TheDjabra/doggobot/docs/architecture.md

# Architecture

## The one integration point

The car already runs the UCSD robocar ROS2 framework (`ucsd_robocar_hub2`). The entire seam
between this project and that framework is a single topic: **`geometry_msgs/Twist` on
`/cmd_vel`**, consumed by `vesc_twist_node` in `ucsd_robocar_actuator2_pkg`. `linear.x` is
throttle, `angular.z` is steering. Publish valid Twist there and the car moves.

Nothing in the framework is forked or modified. This project adds nodes alongside it. Reading
across prior teams in the course GitHub org, the teams that extended the framework this way
consistently did better than the teams that forked it.

DonkeyCar is not used. DonkeyCar is the behavioral-cloning path from an earlier assignment
(record frames, train a CNN, let it drive). Every prior voice-controlled and target-following
team in the org also built ROS2 packages rather than extending DonkeyCar.

## The single-publisher rule

**Exactly one node publishes `/cmd_vel`.** Two publishers on one topic is not an error in
ROS2, it is a race: the actuator receives interleaved messages from both at whatever rate
each happens to run, so a "stop" and a "follow" alternate and the car twitches. Every other
behavior publishes to its own intermediate topic and an arbiter node decides.

```
voice_bridge_node   -> /voice_cmd       (FastAPI + rclpy in one process)
perception_node     -> /target_state    (DepthAI spatial detection + ObjectTracker)
behavior_node       -> /behavior_cmd    (primitives + the sequencing executor)
safety_node         -> /safety_cmd      (LiDAR proximity, e-stop)
                            |
                        arbiter_node -> /cmd_vel     <- sole publisher
```

**The same rule now applies to the camera.** Three things want to aim the pan axis: the follow
cascade, a spoken "atlas look left", and the phone's slider. `behavior_node` is the sole
`/pan_cmd` publisher and `pan_node` is the sole writer to the serial port, so the two never
interleave half-written command lines on a 1 Mbps bus.

```
follow_node        -> /follow_pan     (tracking wants the camera here)
voice_bridge_node  -> /pan_manual     (the phone slider asks for this)
stt_node           -> /voice_cmd      ("look left")
                            |
                     behavior_node -> /pan_cmd     <- sole publisher
                            |
                        pan_node -> serial -> ESP32 -> STS3215
                            |
                     /pan_state (measured angle, load, volts, temp, ok)
```

Pan priority, highest first: follow tracking, then a manual look, then recentre when idle.
Tracking outranks a manual look because the tracker is closing a loop with better information
about where the target is; a held manual angle would simply be fought once per frame.

`/pan_state` carries `ok`, which goes false when status lines stop arriving. That is what lets
the follow cascade fall back to fixed-camera behaviour instead of steering the car on a pan
angle frozen at whatever it last happened to be.

Arbiter priority, highest first: e-stop, then safety override, then the active primitive.
Its timer runs at 10 to 20 Hz and publishes on **every** tick, not only on change, because
the base controller times out on missing `/cmd_vel` messages and zeroes the motors. That
timeout is a safety property: the point of streaming commands is the failure case, when a
publisher crashes or the network drops.

## Node responsibilities

**`voice_bridge_node`** serves the phone web app and turns input into structured commands.
One process running FastAPI and `rclpy` together: `rclpy.init()`, a node holding the
publishers, spun in a background thread, with the WebSocket handler calling into it. A
separate rosbridge server was considered and rejected, because a server process is needed
anyway to serve the page over HTTPS, proxy the LLM call so the key stays out of the browser,
and run the parser.

**`perception_node`** runs the DepthAI pipeline: ColorCamera preview into a
`YoloSpatialDetectionNetwork` with StereoDepth linked, into an `ObjectTracker`, out over
XLink. The spatial network returns per-detection XYZ in millimetres computed on the camera,
so no depth math happens on the Pi. The tracker assigns persistent IDs with
NEW/TRACKED/LOST/REMOVED states, which is what "lock onto a target" means here: no hand-rolled
association logic, and the LOST state is a free grace period before declaring the target gone.

**`behavior_node`** owns the primitives, the vocabulary, and the sequencing executor, and is the
sole publisher of `/behavior_cmd`. Primitives: forward, reverse, circle_left, circle_right, wait,
stop, and follow. Follow is a primitive rather than a parallel system, so mutual exclusion is
structural: `follow_node` publishes `/follow_cmd` and this node relays it only while follow is
the active mode.

Every moving primitive is time-bounded. "Forward until further notice" is how a car ends up in a
wall when a link drops.

The executor runs an ordered list of steps. Spoken chains ("forward then circle left then stop")
are a keyword split, which covers the common case without an LLM's latency or network dependency.
A chain where any step fails to parse is refused entirely rather than partially executed. Steps
may carry an `until` condition read from `/condition_state`; nothing publishes that yet, and the
step's duration doubles as a timeout so a condition that never arrives cannot strand the car.

**`arbiter_node`** is the sole `/cmd_vel` publisher, as above.

**Threading note:** perception and control stay in separate nodes because the default `rclpy`
executor runs one callback at a time with no preemption. A vision callback that overruns
delays the control timer by exactly its overrun.

## Message types

`std_msgs/String` carrying JSON on the intermediate topics; `geometry_msgs/Twist` only at
the arbiter output. Custom ROS2 message definitions require a CMake package, which is
friction with no payoff at this scale.

## Control

**PID only.** Steering is a PD loop on the tracklet's horizontal offset from frame center.
Throttle is a PD loop on measured distance against a setpoint. LQR and LQG are deliberately
out of scope: state-space control needs a model of a plant you understand, and this vehicle
was not built by us. The class framework is PID-shaped already
(`Kp_steering`/`Ki_steering`/`Kd_steering`), so this also means less to fight.

Kalman filtering remains available as an optional smoothing layer on the target estimate,
not as a controller, and only with evidence it is needed: the ObjectTracker already runs its
own Kalman filter on-camera.

## Voice input

Two tiers, for latency and for robustness:

- **Fast path**: fixed commands (stop, wait, follow, circle, figure-8, loop) matched by
  keyword on the phone with no model call. Near-instant.
- **Slow path**: arbitrary sequences go to an LLM that emits a schema-constrained list of
  primitives from a fixed vocabulary.

The fast path alone runs the entire graded demo, so a failure of the LLM tier or its network
dependency degrades the system rather than stopping it.

Speech is captured in the browser on the phone, not on the car. This keeps speech-to-text
compute off the Pi entirely (only short text strings cross the network) and keeps the
microphone at the speaker's mouth rather than on a vehicle that is driving away.

## Target reacquisition

The camera is on a pan servo. On target loss the system holds a short grace period, then
sweeps the camera to search for the target, re-locks, and resumes. This exists because a
prior team documented reacquisition-after-loss as an unsolved problem in their own project,
where the robot simply stopped when the target left frame.

Because the camera pans independently of the chassis, steering error is the sum of the
servo's own angle and the target's offset within the frame, not the offset alone. Likewise,
the depth reading is a range along the camera's optical axis: forward distance is
`Z*cos(pan)` and lateral offset is `Z*sin(pan)`. This is implemented as the cascade below.

## The LiDAR guard, and its override

`safety_node` watches the 290 degrees the camera cannot see and vetoes motion by
publishing a zero Twist that the arbiter ranks above everything but the e-stop. It
publishes **only while intervening**, because a continuous publisher at that priority
would veto the whole system permanently.

Two properties are worth knowing, both learned on the car on 2026-09-01.

**A threshold with no hysteresis chatters.** The guard compared range against a fixed
stop distance at 20 Hz. An object sitting near that distance makes the estimate dither
across it, so the veto toggled every tick and a 3 second command arrived as a series of
lurches: 16 stop/clear cycles in one minute. A release margin and a minimum block time
fix it. Both only delay a *release*, never an intervention, which is what made the
change safe to ship: measured, the car still stops at exactly 0.25 m.

**The override is an override, not an off switch.** On a stand the guard measures the
bench, a chair leg, a foot, and vetoes every command for obstacles that are real but
irrelevant. The phone can turn it off, under three constraints:

- it defaults to ON, and boots ON, so a restart or a crash never silently leaves the
  car unguarded;
- it is re-enabled automatically whenever the last client disconnects, alongside the
  disarm, because the operator who switched it off has walked away;
- the guard keeps **running** while overridden. It still computes and publishes what it
  would have stopped for, so the page shows "would stop: right" rather than going blank.
  Only the veto publish is withheld. The operator can therefore see what they are
  overriding, which is the difference between an informed override and a blindfold.

## The follow cascade

The camera and the steering are not two controllers on one error. They are a cascade, and each
loop closes on a different error:

| Loop | Error | Actuator | Job |
|---|---|---|---|
| inner | `x`, bbox offset | pan servo | keep the target centred in frame |
| outer | bearing | steering | point the chassis where the camera looks |
| outer | `z_mm` | throttle | hold the standoff |

The camera chases the target and the car chases the camera. When the pan angle returns to zero
the car is aimed at the target by construction. This is gaze stabilisation on a mobile base.

The bearing is the whole trick:

    bearing_deg = pan_deg + x * half_fov_deg
    err_steer   = bearing_deg / half_fov_deg

Note what that collapses to when `pan_deg` is zero: `err_steer == x`, exactly the fixed-camera
controller. So an unplugged ESP32, a dead servo, or `use_pan: false` all degrade to the old
behaviour with the old gains, rather than to a special case that only ever runs when something
is already broken.

### Why it is worth the extra actuator

Simulated before any of it touched the car, in `tools/sim_cascade.py`, which stubs rclpy and
drives the real `FollowNode` rather than a copy of its equations:

| Scenario | Fixed camera | Pan cascade |
|---|---|---|
| Approach from 28 deg off | camera 2.8 deg off target | 0.3 deg |
| Tight turn, 31 deg off at 1.7 m | 16.6 deg off | 0.6 deg |
| Person walks around a car stopped at the standoff | **target out of frame 89% of frames** | **0%** |

The last row is the case that justifies the hardware. Once the car reaches the standoff it
stops, and a non-holonomic vehicle cannot change heading while stopped. From that moment the
chassis has no authority over framing at all and the camera is the only thing that can aim.

### The traps, and what was done about each

**Stale angles.** `x` describes a frame captured about 100 ms ago; the pan angle read now is
not the angle the camera had when that frame was taken. At 120 deg/s that is 12 degrees of
fiction, larger than the errors being controlled, and it presents as a mistuned gain that no
amount of tuning fixes. `follow_node` keeps a ring buffer of `(timestamp, angle)` and looks the
angle up at the frame's own stamp, offset by `capture_lag_s`.

**Three signs meet here** (`x`, pan, `angular.z`) and any one of them backwards turns
convergence into divergence. They are defined once, in the `pan_node` docstring. The simulation
deliberately inverts each one as a control case, so the test is known to be able to see the
failure it claims to rule out.

**A car cannot strafe.** Above `align_before_drive_deg` the throttle is cut, because closing on
a target 50 degrees off the nose mostly makes the angle worse; below it the throttle is scaled
by `cos(bearing)`. If the camera stays pinned beyond `pan_escalate_deg`, the chassis has failed
to come round and steering harder cannot help, so `behavior_node` can escalate to a three-point
turn. That escalation ships **off** by default: it is the newest path here and a surprise
three-point turn during the demo is worse than a wide arc.

**Depth is a range along the optical axis**, so it stays the right error for a standoff
regardless of bearing. The throttle loop is unchanged.

## Losing the target, and going to look for it

A lock does not fail cleanly. The tracker keeps a `LOST` tracklet alive for a while to bridge a
brief occlusion, which is useful for the follow controller and misleading for anything waiting on
the lock to drop.

So the search clock starts at **`LOST`, not at lock-drop**, and after a grace period the camera
sweeps to find the target again, starting toward the side it was last seen on because that is
where it most likely still is. Priority on the pan axis is follow tracking, then a spoken look,
then the sweep, then recentre.

**The sweep is the easy half.** `perception_node` clears `want_lock` when a target is `REMOVED`,
so a camera that swept beautifully and never asked for a lock again would pass straight over the
person and latch onto nothing, while looking exactly like a camera that is working. Search
re-requests the lock, and releases it if it gives up.

The grace period earns its place too: a lock often drops for a fraction of a second when someone
turns or is briefly occluded, and sweeping instantly would drag the camera off a target that was
about to come back.

## Distances and angles, and why they are not the same problem

"Forward one metre" becomes a duration, because the class actuator node holds the motor
controller's serial port and publishes no telemetry, so wheel travel is unreadable while the
stack runs. That makes it dead reckoning, and dead reckoning is only as good as its constants.

Measured on the vehicle rather than assumed:

    distance = rate * time + coast      0.635 m/s, 0.144 m
    angle    = rate * time              45 deg/s, no coast term

**Distance needs a coast term and turning does not**, which is not obvious and is worth the
sentence. The car rolls about 14 cm after a command ends. Turning is immune because the arbiter
publishes a zero Twist when a command finishes, so the steering centres and the car coasts
straight rather than continuing round.

It matters most at the distances actually used indoors: dividing distance by a rate alone, a
0.3 m command travelled 0.45 m, fifty per cent over. `tools/calibrate_motion.py` re-measures both,
and refuses any sample where the LiDAR guard cut in mid-run, since that would quietly shorten the
result.

## Close-range framing

The camera pans but does not tilt, so a person at close range overflows the vertical field
of view and the detector sees a torso crop, exactly when the car is nearest and least able
to recover from a lost lock. Mitigations: drive the loop on horizontal offset only, never
gate on box height or aspect ratio, use asymmetric confidence thresholds (strict to acquire
a lock, lenient to hold one), and set the follow standoff above the distance where framing
degrades rather than fighting it.
