TheDjabra/doggobot/docs/MAE148-Team4-Final-Presentation.pdf

# Voice-Controlled Autonomous Navigation — DoggoBot

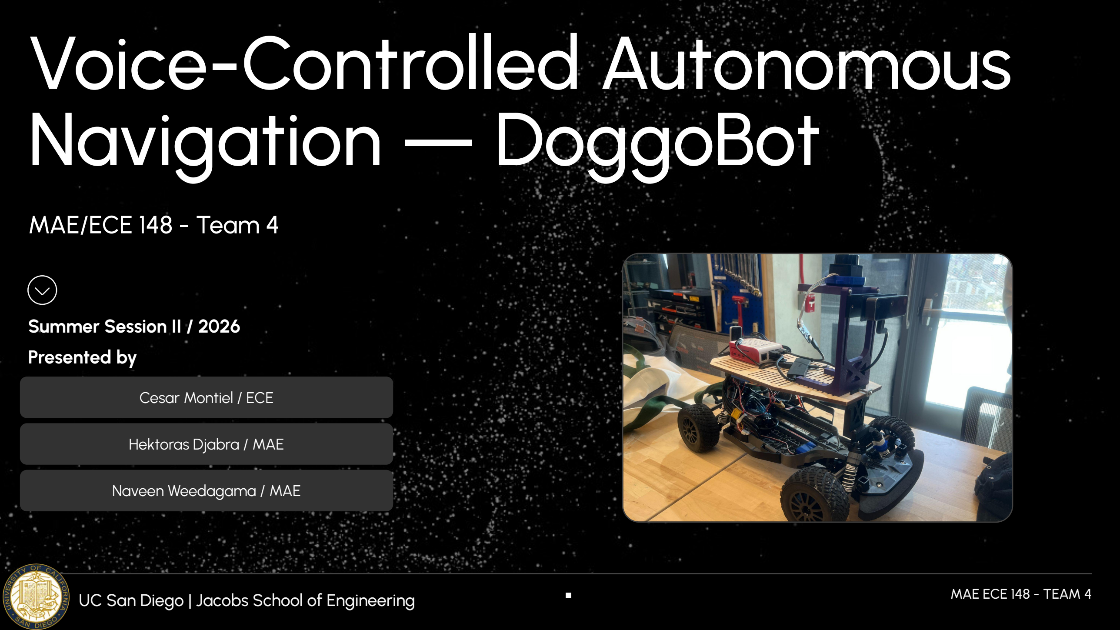
[picture p8: page 1]

Cesar Montiel / ECE

## MAE/ECE 148 - Team 4

UC San Diego | Jacobs School of Engineering

Summer Session II / 2026
Presented by

Hektoras Djabra / MAE

Naveen Weedagama / MAE

MAE ECE 148 - TEAM 4

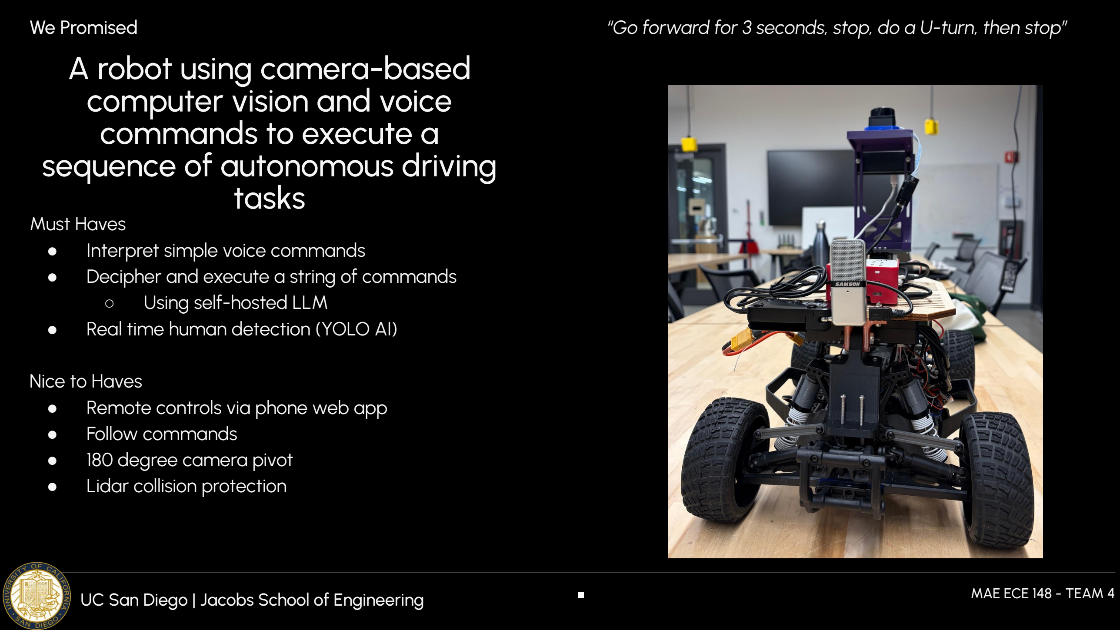
[picture p9: figure]
A robot using camera-based computer vision and voice commands to execute a sequence of autonomous driving tasks; MAE ECE 148 - TEAM 4; Must Haves ● Interpret simple voice commands; ○ Using self-hosted LLM ● Real time human detection (YOLO AI); Nice to Haves ● Remote controls via phone web app ● Follow commands ● 180 degree camera pivot ● Lidar collision protection

- Decipher and execute a string of commands
We Promised | “Go forward for 3 seconds, stop, do a U-turn, then stop”
UC San Diego | Jacobs School of Engineering

## Primary Demonstration

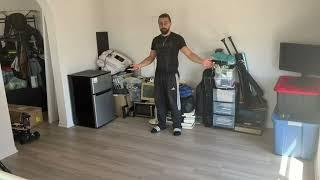
[picture p10: figure]

MAE ECE 148 - TEAM 4 UC San Diego | Jacobs School of Engineering

## Secondary Demonstration

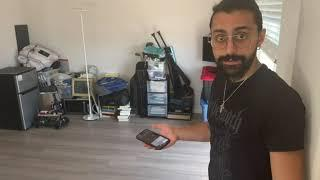
[picture p11: figure]

## What Worked

## Roadblocks

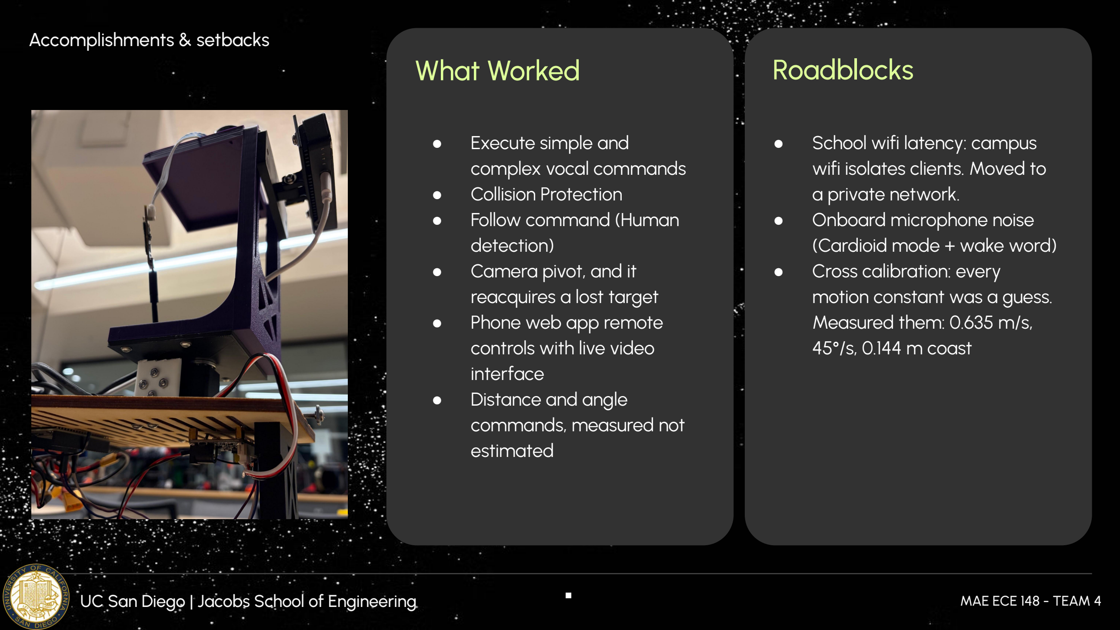
[picture p12: page 5]

- Execute simple and
complex vocal commands
- Collision Protection
- Follow command (Human
detection)
- Camera pivot, and it
reacquires a lost target
- Phone web app remote
controls with live video
interface
- Distance and angle
commands, measured not
estimated
- School wifi latency: campus wifi isolates clients. Moved to a private network.
- Onboard microphone noise (Cardioid mode + wake word)
- Cross calibration: every motion constant was a guess. Measured them: 0.635 m/s,
45°/s, 0.144 m coast

Accomplishments & setbacks

UC San Diego | Jacobs School of Engineering | MAE ECE 148 - TEAM 4

## Phone Web App

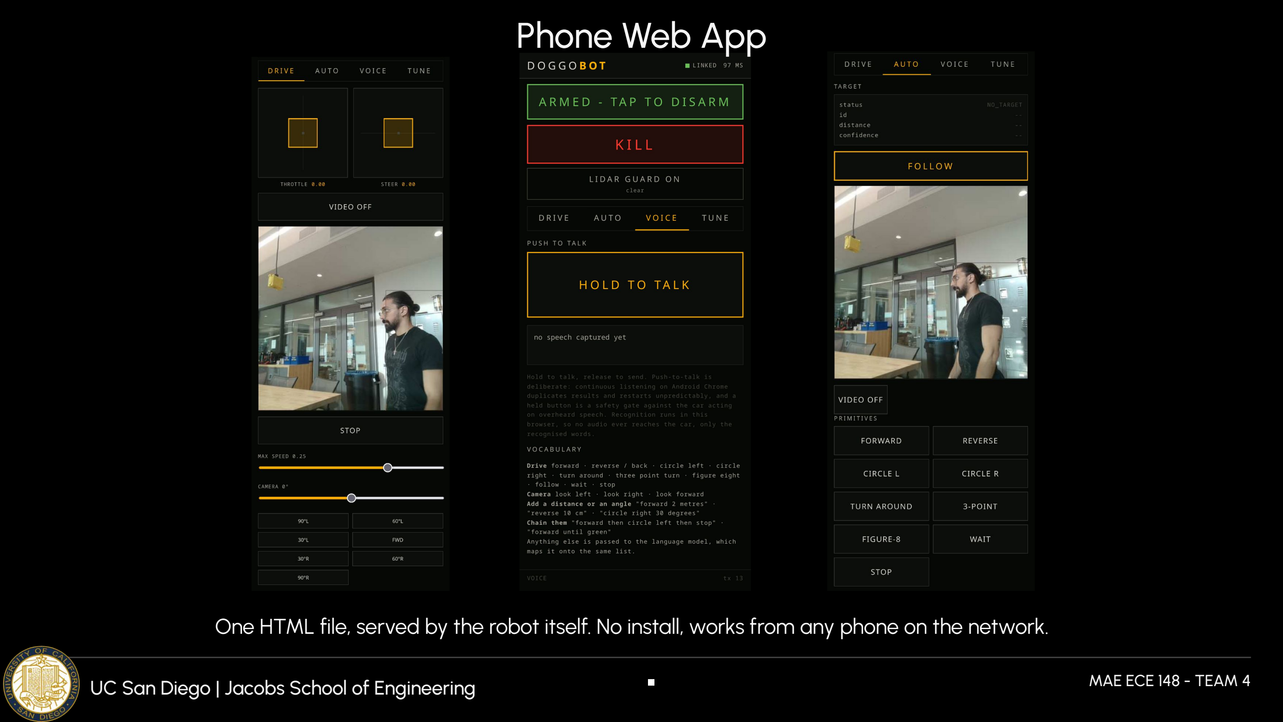
[picture p13: page 6]

One HTML file, served by the robot itself. No install, works from any phone on the network.

# What we could’ve done better

- | Better collision protection ○ | | Navigate around obstacles rather than only stopping for
| | | them
- | More robust person detection ○ | | Detector runs at 12 fps; a faster loop would track a moving
| | | person better
- Only the person class is loaded, so a coat rack can read as a
| | | person at high confidence
- Cluttered rooms degrade it
- | More robust following ○ | | The camera and steering cascade took significant tuning to
| | | stop it overshooting; more time would buy a better-behaved
| | | loop
- | Wider detection ○ | Facial recognition, so it knows its owner ○ | Objects beyond people

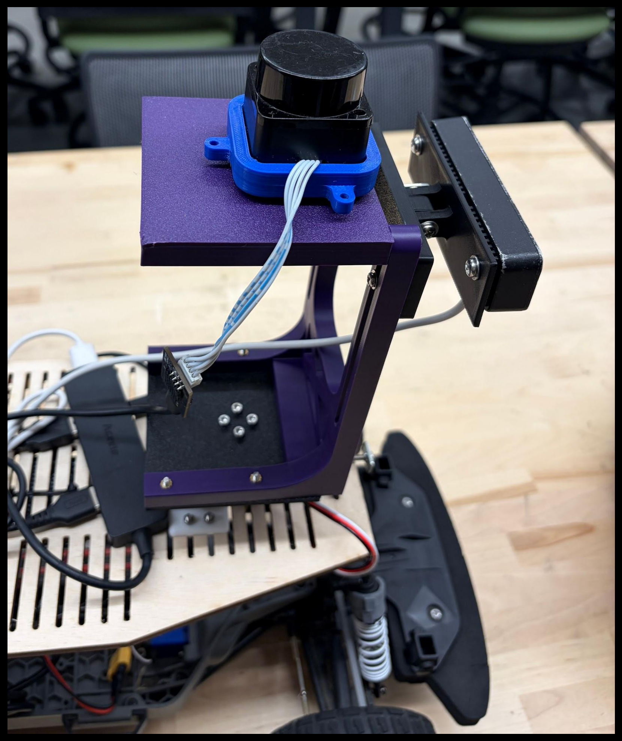
[picture p14: figure]

UC San Diego | Jacobs School of Engineering | MAE ECE 148 - TEAM 4

## Gantt Chart

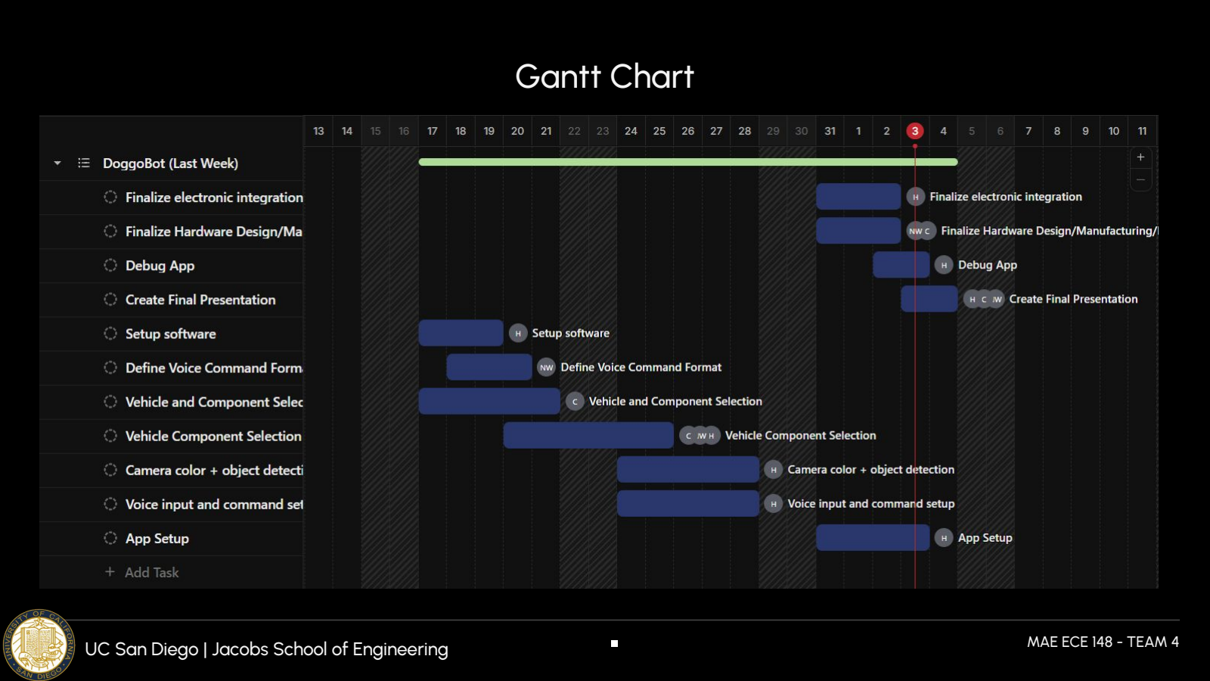
[picture p15: page 8]

# Lessons Learned

## Measure don't estimate

## Confidence is not correctness

## Ensure enough wire and mechanical clearance Capability has a compute budget

# Thank you

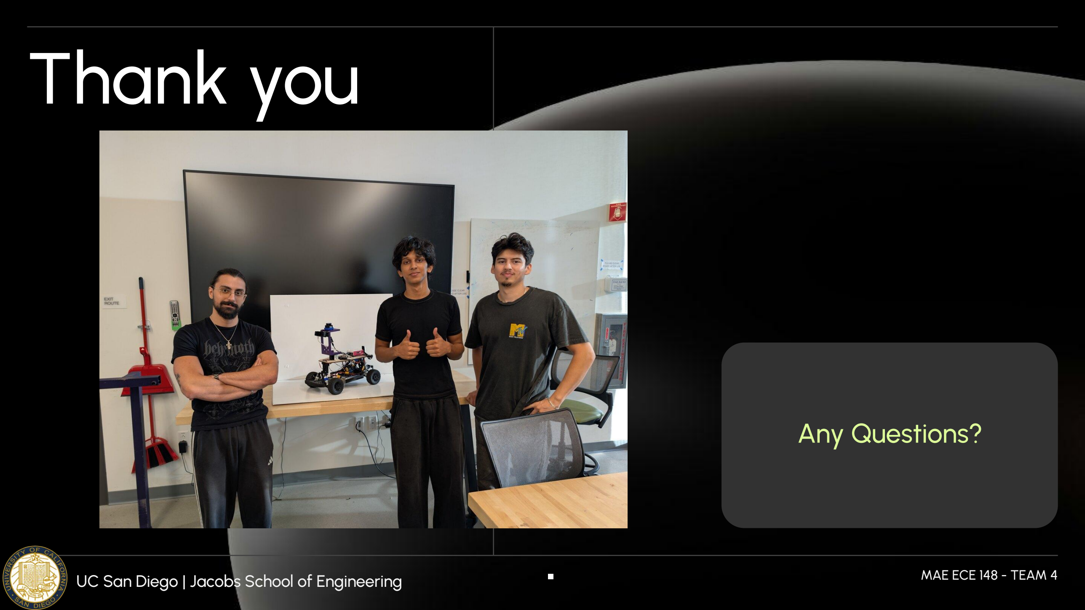
[picture p16: page 10]

## Any Questions?

UC San Diego | Jacobs School of Engineering | MAE ECE 148 - TEAM 4
