TheDjabra/doggobot/cad/Front_Support.STEP

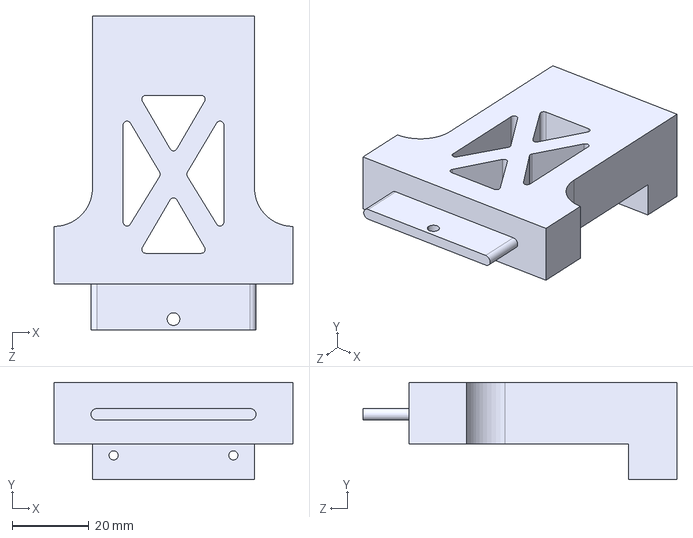
[picture p17: CAD file, 2026-09-03]
cad/Front_Support.STEP
62.2 x 25.4 x 81.8 mm
