TheDjabra/doggobot/cad/Baseplate.STEP

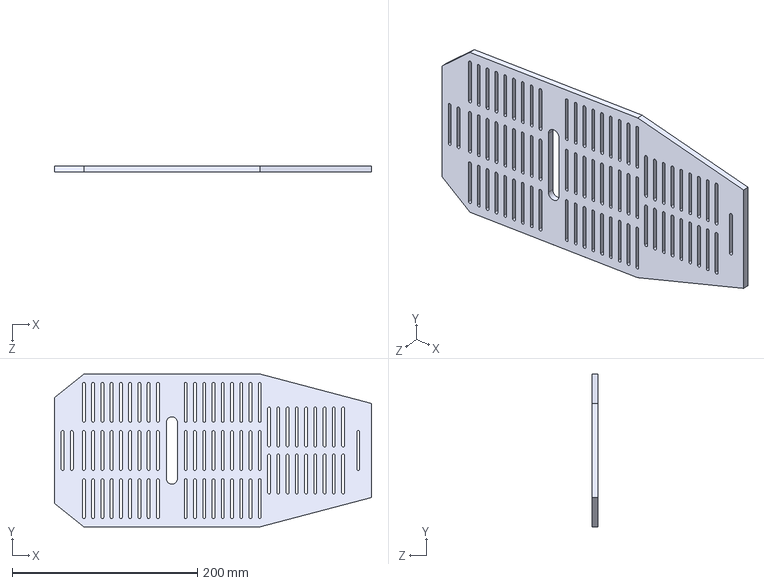
[picture p18: CAD file, 2026-09-03]
cad/Baseplate.STEP
342.5 x 165.1 x 6.35 mm
