TheDjabra/doggobot/cad/Hinge.STEP

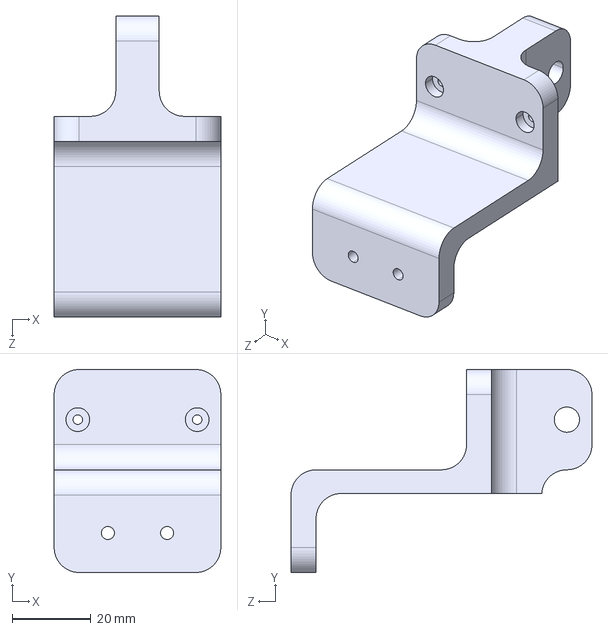
[picture p19: CAD file, 2026-09-03]
cad/Hinge.STEP
42.2 x 51.4 x 76.2 mm
