TheDjabra/doggobot/cad/Servo_To_Chassis_Mount.step

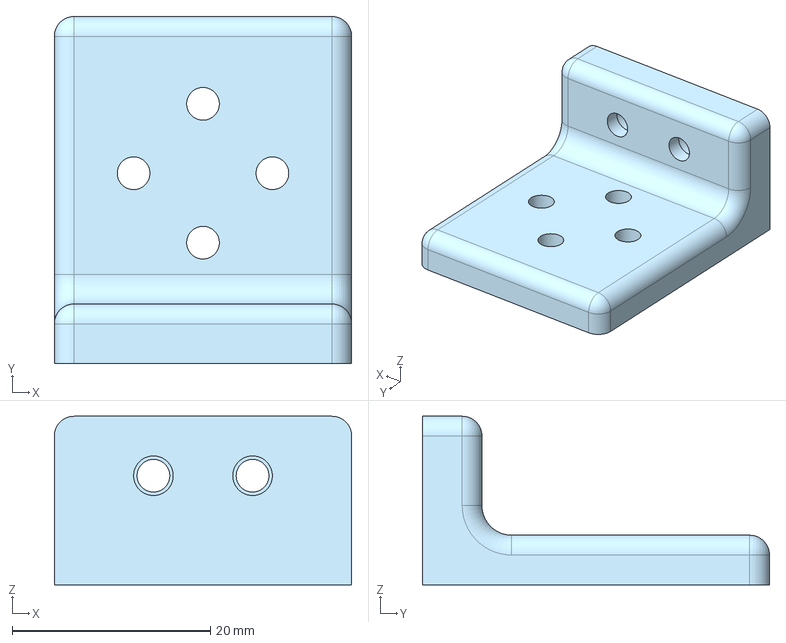
[picture p20: CAD file, 2026-09-03]
cad/Servo_To_Chassis_Mount.step
30.0 x 35.0 x 17.0 mm
