TheDjabra/doggobot/cad/Camera_Chassis_Mount.step

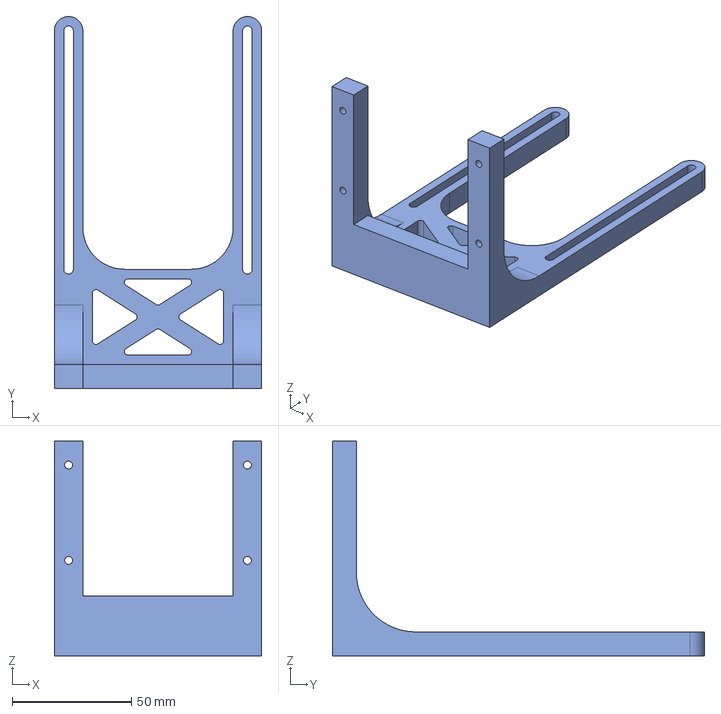
[picture p21: CAD file, 2026-09-03]
cad/Camera_Chassis_Mount.step
87.0 x 156.0 x 90.0 mm
