TheDjabra/doggobot/cad/Camera_Angle_Bracket.step

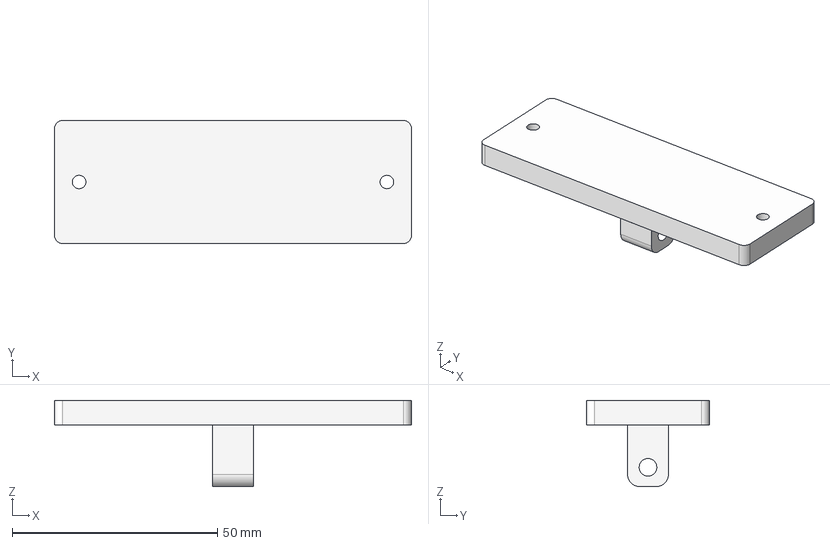
[picture p22: CAD file, 2026-09-03]
cad/Camera_Angle_Bracket.step
87.0 x 30.0 x 21.0 mm
