TheDjabra/doggobot/cad/Servo_Mount.step

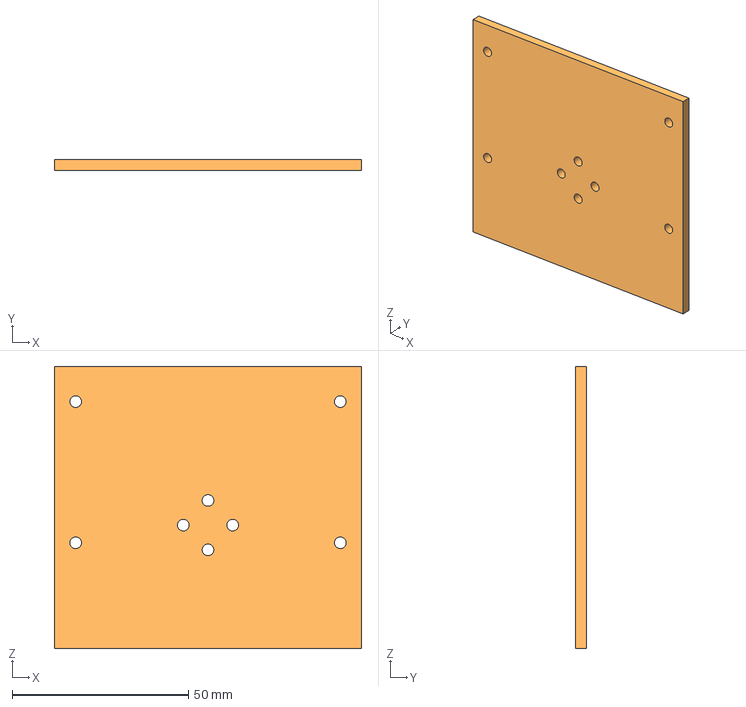
[picture p23: CAD file, 2026-09-03]
cad/Servo_Mount.step
87.0 x 3.00 x 80.0 mm
