TheDjabra/doggobot/cad/Camera_Angle_Mount.step

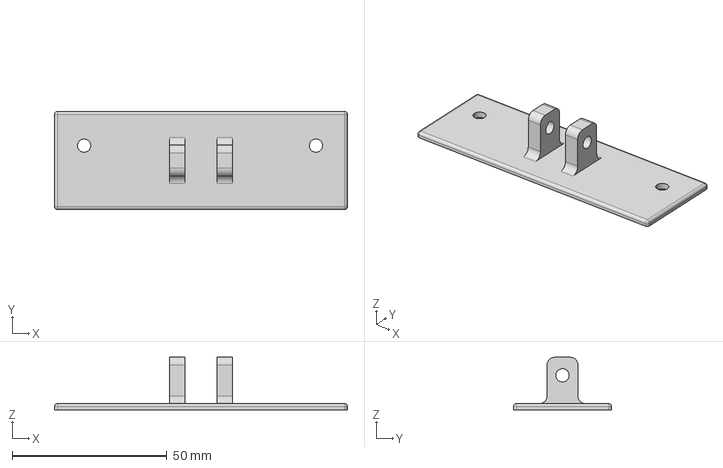
[picture p24: CAD file, 2026-09-03]
cad/Camera_Angle_Mount.step
94.8 x 31.8 x 17.0 mm
