TheDjabra/doggobot/(list of files, cad)

Other CAD files:
cad/Baseplate.STL
cad/Camera_Angle_Bracket.stl
cad/Camera_Angle_Mount.stl
cad/Camera_Chassis_Mount.stl
cad/Front_Support.STL
cad/Hinge.STL
cad/Servo_Mount.stl
cad/Servo_To_Chassis_Mount.stl
