TheDjabra/doggobot/build_log.md

# Build log

Dated engineering record: what was done, what broke, and why decisions went the way they
did. Written as the work happens, not reconstructed afterward. Source material for the
final report and the project writeup.

---

## 2026-08-25 - Container and repository set up

**Container.** The final project runs in its own container, `Doggobot`, cloned from the
graded-assignment container `robocar_team_4` rather than built fresh from the upstream
image. The reason is that three fixes made during the assignment live only in that
container's filesystem and would be lost by pulling the stock image again:

1. A settle delay added to `pyvesc/VESC/VESC.py`, fixing a partial-read race where the
   library decoded a 43-byte VESC reply after only 4 bytes had arrived and returned the
   string `None`.
2. `setuptools` pinned to 69.5.1, because the shipped 82.0.1 is above `colcon-core`'s own
   declared ceiling and breaks `--symlink-install`.
3. A corrected `source_ros2` alias that also sources `sensor2_ws`, without which the OAK-D
   packages are invisible to ROS2.

Cloned with `docker commit robocar_team_4 team4_final:base`, then run as `Doggobot`.
Verified after creation that all three fixes survived.

**Domain ID.** Set to 66 to keep this node graph separate from the assignment container's.
This had to be changed in two places, not one: the image's own `bashrc_docker.sh` exports
`ROS_DOMAIN_ID=96` on every interactive shell and overrides whatever `docker run -e` set,
so the authoritative value is the later export in `/root/.bashrc`. Verified through an
actual interactive shell rather than trusting the flag.

**Flags changed from the class `robocar_docker()` function.** Dropped `--device /dev/video0`,
which does not exist on this Pi (only `/dev/video19` through `23`, the ISP and codec nodes)
and would have made `docker run` fail. `--privileged` shares the host `/dev` regardless,
which is how the VESC and OAK-D are reachable.

**Added a source bind mount**, `/home/pi/doggobot` on the host to
`/home/projects/ros2_ws/src/doggobot` in the container. The class container mounts no
source volume, so any code written inside it exists only in a container layer, is not in
version control, and dies with the container or at kit return. A bind mount can only be
added at container creation, so it was free now and would have cost a full recreate later.

**Inherited calibration.** The clone carries the assignment's tuned values, so this
container can drive the ROS2 laps as-is: `Kp 0.2 / Ki 0.0 / Kd 0.1`, steering limits
+/-0.8, `max_throttle 0.382`, `min_throttle 0.363`.

**Note:** the two containers must not run at the same time. Separate domain IDs keep their
node graphs apart but do not stop them contending for the same VESC serial port and the
same OAK-D on the USB bus.

**Repository.** Scaffolded as an `ament_python` package so `colcon build` finds it, and
pushed to GitHub. The Pi holds a working clone at the bind-mount path.

---

## 2026-08-25 (lab) - Tailscale, arbiter_node, first bench motion

**Tailscale on the car.** Installed and joined the tailnet as `doggobot`
(`100.108.50.81`, `doggobot.tail502ca5.ts.net`). Two reasons, one immediate and one
structural. Immediate: campus wifi uses client isolation, so mDNS stopped resolving
`ucsdrobocar-148-04.local` the moment we left the home network, and the car became
unreachable. Structural: `tailscale cert` issued a real publicly-trusted certificate for that
hostname, which is what the phone app needs. The Web Speech API refuses to hand a page a
microphone on an insecure origin, so this was not convenience, it was a prerequisite for
voice input. Verified rather than assumed by issuing a cert and then deleting it.

Note: on campus wifi the tailnet connection routes through a relay in LA rather than
peer-to-peer, which adds latency. That should resolve when the phone and car are on the same
hotspot at demo time, but it needs measuring before we stream joystick input at 20-30 Hz.

**`arbiter_node`.** Written and passing a 10-case logic test with no actuator attached:
priority order, per-source staleness timeouts, latched e-stop, and output clamping. The test
harness lives at `tools/test_arbiter.sh` and is repeatable.

**`tools/env.sh`.** The first test run failed with `Package 'doggobot' not found`. Cause:
`source_ros2` is a shell *function* defined in the image's `/home/scripts/bashrc_docker.sh`,
and functions and aliases do not exist inside a child script. Sourcing that file directly is
not a fix either, because it ends with `export ROS_DOMAIN_ID=96` and would have silently moved
the project onto the wrong domain. So the environment is now explicit and version-controlled:
domain 66, every driver workspace, then ours last.

**Throttle units, corrected before commanding motion.** `vesc_twist_node` reads the
calibration file and computes `max_rpm = max_throttle * max_rpm = 0.382 * 20000 = 7640` ERPM,
then commands `rpm = 7640 * msg.linear.x`. So Twist `linear.x` is a *fraction* of an
already-capped range, not the calibration value itself. The arbiter's `max_throttle` is
therefore a second, project-level speed limit, and it was initially set to 0.382 under the
wrong assumption. Lowered to 0.15 (roughly 1150 ERPM) as a deliberately slow bench default, to
be raised only after speed is measured on the ground.

Also worth noting: `vesc_twist_node`'s callback does **not** clamp steering to
`max_left_steering`/`max_right_steering`. It computes those limits and never applies them. The
arbiter's clamp is therefore the only thing preventing an out-of-range servo command.

**First bench motion, and the bug it caught.** With the car on blocks, a steering sweep
produced servo noise but no visible wheel movement. `ros2 topic info /cmd_vel` reported
**Publisher count: 2**. An orphaned `arbiter_node` from the earlier test run was still alive
and publishing zeros at 20 Hz, so the VESC was receiving 0.8 and 0.0 alternately and the servo
was being commanded to 0.9 and back to center twenty times a second.

Root cause: `ros2 run` is a launcher and the node is its child, so `kill $!` in the test script
killed the launcher and orphaned the node. Fixed in `tools/test_arbiter.sh` by killing the node
by name and by adding a preflight check that refuses to run when an arbiter is already alive.

This is worth remembering as a class of bug rather than an incident: **the symptom looked
exactly like a hardware fault** (servo buzzing, nothing moving), and nothing in either node's
logs was wrong. `ros2 topic info` was the tool that found it in seconds. It is also a direct
vindication of the single-publisher rule the whole architecture is built on.

**Silent motor, and the measurement that explained it.** First throttle commands (0.05, 0.10)
produced no wheel movement. Rather than guess, `tools/vesc_probe.py` was written to talk to the
VESC directly with ROS out of the picture: read telemetry, then step RPM and read back what the
motor actually did. Result: firmware 6.6.55, 15.1 V input, no fault codes, and a motor start
threshold **between 500 and 1000 ERPM**. The failing commands were 382 and 764 ERPM. Not a
fault, a deadband.

That also exposed a mistake made earlier the same session. The arbiter's throttle ceiling had
been lowered to 0.15 on the reasoning that `vesc_twist_node` already caps at 0.382. It does, but
the class's own `lane_guidance_node` publishes `linear.x` between 0.363 and 0.382, so 0.15 was
*below the speed the car is calibrated to drive at*. Ceiling restored to 0.382, with the
measured floor of 0.13 recorded as a parameter and published in the arbiter's status so
behaviours can respect it.

**A second two-publisher incident, same root cause, different mechanism.** A cleanup command
`pkill -f arbiter_node` matched the very shell that was running it, so the shell killed itself
partway through and the remaining kills never executed. A subsequent launch then created a
second stack. Fixed with `tools/stop_stack.sh`, which matches installed binary paths using
bracket patterns (`arbiter_nod[e]`) that cannot match its own command line, and verifies nothing
survived. The lesson generalises: `ros2 topic info /cmd_vel` reporting a publisher count other
than 1 is now the first thing checked before any bench test, and both test harnesses refuse to
run otherwise.

**Battery.** Measured 15.1 V, so a **4S** pack, which is what every team received. The recorded
VESC motor-wizard configuration says 3S Li-ion. If that is still set, the low-voltage cutoff
will not protect this pack. Flagged for checking in VESC Tool.

**Bench results, all with the car on a stand and exactly one publisher on /cmd_vel:**

- Steering: full right, center, full left, center. Polarity correct, right command gives right.
- Throttle: 0.20 and 0.37 both spin at visibly different speeds. Reverse works at -0.25 and
  -0.37, no brake-then-reverse sequence needed.
- **Deadman**: teleop publisher killed mid-drive with no stop command sent, car stopped itself.
- **E-stop**: engaged while a 0.25 throttle command was still streaming, output zeroed; cleared,
  control resumed with nothing republished.

The drive path is therefore proven end to end: `ros2 topic pub` -> arbiter -> `/cmd_vel` ->
`vesc_twist_node` -> VESC -> wheels, with both safety paths validated on real hardware before
any autonomous behaviour exists.

---

## 2026-08-25 (lab, later) - Phone control surface

**Tailscale on the car.** Joined the tailnet as `doggobot`
(`doggobot.tail502ca5.ts.net`). Two reasons. Campus wifi uses client isolation, so mDNS stopped
resolving the car entirely the moment we left the home network. And `tailscale cert` issues a
real publicly-trusted certificate for that hostname, which is a hard prerequisite for the voice
work: the Web Speech API refuses to give a page a microphone on an insecure origin. Verified by
issuing a cert, not assumed.

**`voice_bridge_node`.** FastAPI, a WebSocket, and `rclpy` in a single process. rclpy spins in a
background thread and the socket handler publishes into it.

    button / stick  ->  /teleop_cmd   (Twist)
    kill switch     ->  /estop        (Bool)
    speech          ->  /voice_cmd    (String JSON)   [transport live, recognition not attached]

One process rather than rosbridge because a server has to exist anyway to serve the page over
HTTPS and later to proxy the LLM call so the key never reaches the browser. Given that,
rosbridge would add a second server and port for nothing.

**Design decisions in the page itself**, each for a reason worth keeping:

- **Teleop is a stream, not a command.** The page repeats the current stick position 20x a
  second. It never sends "drive until told otherwise". A phone that sleeps, locks, or leaves
  wifi simply stops transmitting and the arbiter releases the car within 0.5 s. This is the
  deadman already validated on hardware, reached from the phone side.
- **The kill switch is one WebSocket frame straight to `/estop`.** It depends on no model, no
  recognition, and no network hop beyond the bridge.
- **Sticks spring back to centre on release**, and each pad uses pointer capture so dragging a
  thumb off the pad still tracks rather than sticking at its last value. A car stick that held
  its position would be a runaway waiting to happen.
- **Speed slider starts at 0.13**, the measured motor floor, and the bridge steps smaller
  requests up to it, so a low setting still moves the car instead of feeling like a dead button.
- **Last client out stops teleop**, borrowed from the turret app's rule of disarming the payload
  when the last viewer disconnects.
- **Two-stick RC transmitter layout**: left vertical is throttle, right horizontal is steering,
  so muscle memory transfers. Each pad captures its own pointer, so both thumbs work at once.
  Landscape puts them at the screen edges with the controls between.
- **Push-to-talk, not continuous listening**, even in the skeleton. Continuous recognition on
  Android Chrome duplicates results and restarts unpredictably, and a held button doubles as a
  safety gate against the car acting on overheard speech.

Styling reuses the AI TURRET HUD's design tokens directly (square corners, bone white on
near-black, amber accent, condensed display over mono data) so the two projects read as one
system. Written as a single self-contained page rather than a React build, deliberately: a Vite
toolchain would have consumed the whole available window for no functional gain yet.

**Bug found and fixed:** `self.clients` collides with `rclpy.node.Node.clients`, a read-only
property listing a node's service clients. The node died at construction with
`property 'clients' has no setter`. Renamed to `client_count`.

**Measured**: 35 ms round trip from phone to car and back, over the Tailscale relay, on campus
wifi. That is comfortably inside what a 20 Hz stick stream needs, and much better than feared.
Worth re-measuring at Warren Mall on the phone hotspot, where it should improve further because
Tailscale can then connect peer-to-peer over the local network instead of relaying.

---

## 2026-08-26 (lab) - Perception: getting the detector running under DepthAI v3

**GPS removed**, LiDAR fitted. The USB bus is now VESC on `ttyACM0`, LD06 on `ttyUSB0`, OAK-D
on USB, which is tidier than before and frees power budget.

**The container runs depthai 3.1.0, not 2.x**, and the class's own `multi_cam_node.py` is
written against the v3 API (`pipeline.create(dai.node.Camera).build(...)`,
`requestOutput(...).createOutputQueue()`). Prior research notes said to pin v2; doing so would
have broken the course camera node. v3 has everything the follow design needs: `NNArchive`,
`DetectionNetwork`, `SpatialDetectionNetwork`, `ObjectTracker`, `StereoDepth`.

**v3 configures detection through an NN Archive, not setters.** `DetectionNetwork` has no
`setNumClasses`. Rather than re-export the model through a browser, `tools/make_nn_archive.py`
reads the blob's own tensor names and shapes via `dai.OpenVINO.Blob()` and generates a
schema-valid archive around the existing file.

**The subtype trap.** The head metadata's `subtype` must match the export format, not the
architecture generation. Measured against a single person in frame:

- `yolov6`: confidence 0.92, **garbage boxes** (normalised sizes like 8.1 x 24.0, centres
  outside the frame), ~10 per frame
- `yolov8`: one sane box, confidence only ~0.55 (reads 5 channels from a 6-channel tensor)
- `yolov6r2`: one box, confidence 0.94, stable. **Correct.**

The important lesson is that **the wrong subtype reported high confidence**. `yolov6` looked
like a working detector by every metric except the coordinates themselves, and a check of the
form "is it detecting anything" would have passed it while the follow loop chased boxes many
times the size of the image. Normalised box sizes must be within 0..1; printing them is what
found this in one run.

**Validated**: 23.0 fps at 416 (vs 25.6 natively under v2, so ~10% for the v3 pipeline and
letterboxing), 1.07 detections per frame with one person present, best confidence 0.95.

New tools: `tools/make_nn_archive.py`, `tools/probe_blob.py`, `tools/probe_detections.py`.

### Perception pipeline: measured costs, and the tracker trap

Built `tools/probe_perception.py` to measure the full pipeline (stereo depth +
spatial detection + tracking) before writing any ROS2 node that depends on it. Three
resource walls, each of which would have been a mystery later.

**1. SHAVE allocation.** The 6-shave blob refused to start: `Blob compiled for 6 shaves, but
only 5 are available`. With StereoDepth, ImageManip, SpatialLocationCalculator and ObjectTracker
each claiming cores, only 5 remain for the network. Recompiled the OpenVINO IR with
`blobconverter(shaves=5)`; no re-export from the original weights needed.

**2. Stereo median filter out of SIPP memory.** `'Median' out of system resources: '126'`.
Turned the median filter off (`initialConfig.postProcessing.median = MEDIAN_OFF`). Depth is
slightly noisier, which the host-side median we apply to Z compensates for anyway.

**3. The ObjectTracker is the bottleneck, and `setRunOnHost(True)` is the fix.**

| Configuration | fps |
|---|---|
| detector alone | 23.0 |
| + stereo depth | 7.6 |
| + tracker on-device (either type) | **1.2** |
| + tracker on host | **11.3** |
| + host tracker, FAST_DENSITY stereo | **12.1** |

Once the NN and stereo have taken their SHAVEs the on-device tracker is allocated exactly one
core and starves. Changing tracker type does not help (colour histogram 0.9, imageless 1.2); the
allocation is the problem, not the algorithm. The Pi has four idle Cortex-A76 cores, so running
it host-side costs essentially nothing and returns a 10x speedup.

**Validated at 12.1 fps**: stable tracklet id, TRACKED on 116 of 121 frames with LOST appearing
briefly as expected, depth following a person between 544 and 1034 mm.

**Model choice, settled on data.** The custom 416 single-class detector gives 12 fps end to end.
The stock COCO export is 640 with 80 classes, roughly 2.4x the pixels and a far wider head,
which would land near 5 fps in the same pipeline. If more classes are ever wanted, train a small
multi-class model at 416 rather than adopt the stock 640 one.

### Power stress test under motor load (2026-08-26)

The OAK-D and LiDAR run from a DC-DC converter off the same 4S pack that feeds the VESC, so
motor current transients sag the source that powers the camera. That failure cannot appear in a
static test, only under motion, which is how it would otherwise be discovered at a demo.
`tools/stress_power.sh` runs perception for 60 s while commanding eight full accelerate and
direction-reversal cycles.

| Measure | Result |
|---|---|
| perception fps under load | **12.3** (12.1 idle: no degradation) |
| tracker | TRACKED 731/738 frames, LOST twice |
| depth | 426 to 2054 mm |
| `vcgencmd get_throttled` | **0x0** |
| FET / SoC temp | 53.2 C |
| USB resets during the run | none |

`0x0` matters more than it looks: bit 16 of that register **latches** if undervoltage has
occurred at any point since boot, so a clean zero after eight hard cycles means the pack never
sagged enough to disturb the Pi and the converter held 5 V through every transient.

The two USB disconnects in `dmesg` are the OAK-D's normal boot and shutdown transitions, where
it re-enumerates between `Movidius MyriadX` (unbooted, `03e7:2485`) and `Luxonis Device`
(running, `03e7:f63b`). Not brownouts.

**Caveat**: the LiDAR was connected but its driver was not streaming, so this measures camera
plus motor, not full peripheral load. Repeat once the LiDAR node runs.

This demotes the powered USB hub from necessary to headroom.

### Full peripheral load: LiDAR + camera + motor (2026-08-26)

The LD06 runs from the class framework's own driver, not the full `all_nodes.launch.py` the
LiDAR assignment used (that launch also starts `lane_guidance_node`, which publishes `/cmd_vel`
and would collide with the arbiter). Just the driver:

    ros2 launch ldlidar ldlidar.launch.py serial_port:=/dev/ttyUSB0

`tools/env.sh` already sources that workspace. Publishes `/scan` at exactly 10 Hz.

Repeated the power stress test with the LiDAR streaming as well:

| Measure | Camera only | Camera + LiDAR |
|---|---|---|
| perception fps | 12.3 | **12.3** |
| `/scan` | n/a | **10.000 Hz held** |
| `get_throttled` | 0x0 | **0x0** |
| temperature | 53.2 C | 53.8 C |
| USB resets | none | **none** |

The LiDAR (direct on a Pi USB 2.0 port, ~2 KB/s) costs nothing measurable. **The powered USB hub
is optional headroom, not a requirement.** Tested in the current wiring deliberately: testing the
hub first would have proven nothing about whether it was needed, and the un-hubbed configuration
is also what exists if the hub ever fails in the field.

**Lock-on state machine validated under load.** This run's tracker statuses:
`NEW 9, TRACKED 666, LOST 187, REMOVED 2`, three distinct tracklet ids. The target was lost and
re-acquired repeatedly out to 2474 mm, so the design behaved as intended: TRACKED while visible,
LOST as a grace period, REMOVED on real departure, and a **new id on re-entry** rather than a
silently reused one, which is the `UNIQUE_ID` policy making "have I lost my target"
unambiguous. REMOVED is the signal the pan-servo sweep will trigger on.

### perception_node (2026-08-26)

Wraps the proven pipeline as a ROS2 node. Publishes `/target_state` (JSON String) at the
pipeline rate; subscribes `/target_lock` for `{"action":"lock"|"release"}`.

    {"locked": true, "id": 0, "status": "TRACKED",
     "x": -0.531, "y": -0.007, "z_mm": 449, "conf": 0.72, "age": 386, "fps": 12.3}

**`x` is an error term, not a coordinate.** Centre-relative, -1..1, so 0 means centred. The
follow controller then closes a PD loop over two numbers and no frame geometry leaks into it.

**Lock-on, not identity.** On `lock` the node picks the highest-confidence tracklet in frame and
follows that id until released or until the tracker reports REMOVED. Recognising a *specific*
person is face re-identification, far more fragile outdoors, and buys nothing for the demo.

**The camera is allowed to disappear.** The pipeline is rebuilt in a loop rather than taking the
node down, because the OAK-D re-enumerates on the USB bus whenever a pipeline starts or stops
and a brownout would look the same. `CAMERA_DOWN` is published while it is gone.

Validated on the car: lock acquired on command, same tracklet id held across hundreds of frames,
LOST appearing as a grace period without dropping the lock, release returning to `NO_TARGET`,
12.3 fps throughout.

**Observation worth acting on**: at `z_mm` ~450 confidence sat at 0.57-0.72, against 0.94 at
conversational distance. That is the close-range vertical-framing problem appearing as a
measurement for the first time: at half a metre the camera crops the body and the 0.5 threshold
has little margin. This is the number that should set the follow standoff, so measure where
confidence peaks by walking a range rather than picking 1.5 m out of caution.

### follow_node (2026-08-26)

`/target_state` -> PD on two numbers -> `/behavior_cmd`. Steering from `x` (bbox centre offset),
throttle from `z_mm` against a standoff, provisionally 1000 mm.

**Status handling.** TRACKED gets full control. LOST holds the last steering and cuts throttle:
the tracker's LOST is a grace period for brief occlusion and not a reason to drop a lock, but
driving toward something we cannot currently see is not acceptable either, so the car stops and
keeps pointing. Anything else publishes **nothing at all** and lets the arbiter's staleness
timeout release the car, which is a safer stop than a stream of zeros because it also covers
this node crashing.

**Derivative is low-passed.** The input arrives at ~12 Hz from a detector, and raw frame-to-frame
differences of a bounding-box centre are mostly noise.

**A watchdog covers perception dying**, so a frozen `/target_state` is not mistaken for "target
centred and stationary".

#### Tuning, measured rather than assumed

Steering gains started from the car's own lane-following calibration (`Kp 0.2 / Kd 0.1`). Same
servo, same geometry, same actuator scale, so a legitimate starting point. Measurement showed
the **error signal's scale differs**: with `x` normalised to +/-1 and steering clamped at +/-0.8,
`kp 0.2` gave `x=+0.455 -> steer=+0.078`, under 10% of available authority for a target half a
frame off centre. A lane centroid deviates a little; a tracked person sits at the frame edge.
Raised to **0.6**, which now gives `x=+0.509 -> steer=+0.357`.

Reverse got its own ceiling (`max_reverse 0.16` against `max_throttle 0.25`). Approaching and
retreating are not symmetric: someone stepping toward the car produces a large negative error
quickly, and the uncapped loop commanded -0.24, which reads as bolting rather than yielding.

#### Validated on the stand

| Input | Commanded |
|---|---|
| `x=-0.014` (centred) | `steer 0.000` (deadband) |
| `x=+0.509` | `steer +0.357` |
| `x=-0.648` | `steer -0.388` |
| `err +1159` | `thr +0.250` (max) |
| `err +424` | `thr +0.130` (stepped to the motor floor) |

**This validates the control LAW, not the control LOOP.** On a stand the car cannot move, so the
error never responds to the output. Overshoot, oscillation, settling time, and whether `kd`
amplifies detector noise are all invisible until the wheels are on the ground. Ground testing is
also when the 1000 mm standoff gets refined against where detector confidence actually peaks.

**Diagnostic lesson**: the first attempt polled `/target_state` and `/cmd_vel` separately about
0.8 s apart, producing pairs that looked like control bugs (a positive throttle next to a
too-close distance) and were pure sampling skew. The controller now logs its inputs and outputs
from the same message, which is the only trustworthy way to read a control loop.

### GROUND TEST: the follow loop works (2026-08-26)

First closed-loop run with the wheels on the floor, using `all.launch.py` with
`follow_firstrun.yaml` (max_throttle 0.15, reverse off, 200 mm deadband) and the phone in hand
for the kill switch. **It follows.** Steering polarity correct, no runaway, no oscillation
severe enough to note.

Also fixed just before the run, and it was a real bug rather than a quirk: on REMOVED,
`perception_node` cleared the locked id but left the lock REQUEST standing, so the next frame
grabbed the highest-confidence person in view. Stepping out of frame and returning silently
handed the lock to someone else. Now REMOVED drops the lock entirely (`relock_on_loss: false`)
and the operator is told. The parameter exists because the pan-servo sweep will want deliberate
re-locking later, which is different: a sweep re-locks having actively searched, rather than
accepting whoever wandered past.

Phone app gained a **FOLLOW/RELEASE** button and a live target panel (status, id, distance,
confidence at 5 Hz). The button reflects what the ROBOT reports rather than what was last
tapped, so a dropped lock turns it off by itself and the two can never silently disagree.

**Known limitation, confirmed in a small room: turning radius.** Worth being precise about the
cause, because it changes what fixes it.

- Raising the steering gain has little headroom left. `max_steer` is 0.7 against the arbiter's
  0.8 clamp, and 0.8 is the calibrated mechanical limit of the servo.
- The car's minimum turning radius is Ackermann geometry. No gain changes it.
- **What the pan servo actually fixes is not the radius, it is losing the target while turning.**
  The camera currently points where the chassis points, so a tight turn sweeps the target out of
  frame exactly when tracking matters most. With the camera panning independently the car can
  take a wide, achievable arc while keeping the target centred throughout.

So the pan servo is not only a reacquisition feature; it is what makes following viable in a
confined space. That reframing should carry into the mount design.

### behavior_node and on-robot speech (2026-08-26)

**Primitives**: forward, reverse, circle_left, circle_right, wait, stop, plus follow. Every
moving primitive is **time-bounded** by default (3 s, circles 6 s, cap 15 s). "Forward until
further notice" is how a car ends up in a wall when a link drops; a duration makes every command
self-limiting. Same reasoning as fall-2024 Team 12 packing a timeout into their messages.

**An architectural fix went in with it.** `follow_node` was publishing `/behavior_cmd`, and so
would a behaviour node: two publishers on one command topic, which is exactly the race the
arbiter exists to prevent, one layer up. Resolved by making **follow a primitive**:
`follow_node` moved to `/follow_cmd` and `behavior_node` is the sole owner of `/behavior_cmd`,
relaying follow when follow is the active mode. Mutual exclusion is now structural, and
commanding any other primitive releases the target lock so the car is never simultaneously
chasing someone and driving a canned trajectory.

Verified on the stand: circle left `z=-0.7`, circle right `z=+0.7`, forward `z=0.0`, matching
the physical steering polarity confirmed earlier.

**Keyword matching lives in `behavior_node`, not the phone**, because both input paths publish
to `/voice_cmd`. The vocabulary sits next to the primitives it names, so neither path can drift
from what the car can do.

#### Speech: Vosk, offline, on the Samson Go Mic

Chosen over faster-whisper (1-2 s per utterance on a Pi 5 CPU, unusable for "stop"), cloud
recognition (reintroduces the network dependency the on-robot path exists to avoid), and
Pocketsphinx (worse at everything here).

Setup notes, each of which cost time:

- **The container could not see the mic** until `docker restart Doggobot`. The `/dev` view was
  snapshotted before the mic was plugged in. Same desync already documented for other devices.
- **The Vosk model must live under the bind mount** (`models/vosk-small-en`), not
  `/home/pi/models`, or the container cannot reach it. Gitignored; `tools/get_vosk_model.sh`
  fetches it.
- **ALSA devices are exclusive**: `arecord` fails while `stt_node` holds the mic, which is a
  useful signal rather than an error.
- The node negotiates audio format and falls back to the device's native rate with software
  downmix and resample, because USB mics frequently refuse 16 kHz mono.

**Diagnosis lesson.** Several recordings decoded to nothing and I began attributing it to
placement and noise. The actual cause was an empty room: the recordings were taken while nobody
was there. A noise-floor measurement (RMS 2786 with nobody speaking, ~8% of full scale) was real
and worth having, but the conclusion drawn from comparing it to a "speaking" test was unfounded
because that test had no speech in it either. **Confirm the experiment ran before interpreting
the result.**

**Cardioid mode is required.** In omni the mic hears the whole room including the Pi's cooler
inches away. Switched to cardioid, recognition went to six of six commands correct:
`'reverse' 'stop' 'circle left' 'stop' 'go forward' 'stop'`. Also note peak hit 32767 (clipping)
when speaking close; back off or reduce gain, since clipped speech loses the detail a recogniser
needs.

**Bug found by testing: Vosk's constrained grammar is a WORD list, not a phrase list.** Given
"back up" in the vocabulary it returns bare `"back"`, which matched none of the full phrases in
the keyword table. Single-word forms added. This is the sort of thing that only appears when a
real person says a real word.

End to end confirmed: speaking "circle left" ran the circle for 6 s and "go forward" ran forward
for 3 s, with nothing typed.

### The throttle floor was wrong: 0.25, not 0.13 (2026-08-26)

Symptom, spotted by Hektoras: the drive was jumpy, and slow even on the ground.

Measured with `tools/vesc_smoothness.py`, which commands a range of ERPM and samples the ACTUAL
rpm repeatedly at each step, because a speed controller that cannot hold a setpoint shows up as
spread between samples:

| throttle | ERPM cmd | rpm mean | spread | motor A | |
|---|---|---|---|---|---|
| 0.100 | 764 | -2 | 42 | 0.17 | does not turn |
| 0.130 | 993 | 1049 | **1676** | **14.60** | jumpy |
| 0.160 | 1222 | 1342 | 708 | 12.76 | jumpy |
| 0.200 | 1528 | 1489 | **1822** | 7.05 | jumpy |
| **0.250** | 1910 | 1896 | **159** | **3.02** | **smooth** |
| 0.300 | 2292 | 2286 | 139 | 2.88 | smooth |
| 0.363 | 2773 | 2767 | 162 | 3.02 | smooth |

**The mistake, and it is worth naming precisely.** Earlier I measured where the motor *starts*
(nothing at 500 ERPM, turning at 1000) and built the whole throttle law on it. **Starting and
running smoothly are different thresholds**, and the second is roughly twice the first. The
class calibration had been saying so the whole time: `min_throttle: 0.363` is
`lane_guidance_node`'s lower **operating bound**, not a safety limit. We had been driving at
0.15, well under half the slowest speed the platform is calibrated to use.

**The current draw matters more than the jitter.** At 0.13 the motor pulled **14.6 A** against
**3.0 A** at cruise: the FOC speed loop fighting itself. Every slow test so far has drawn about
five times normal current while going nowhere useful, which is hard on the motor, the ESC and
the pack.

Raised everywhere: floor 0.13 -> **0.25**, behaviour cruise 0.16 -> 0.30, follow max 0.15 ->
0.28, teleop ceiling 0.30 -> 0.38.

**Consequence to accept or engineer around**: the car now has no slow speed. It moves at 0.25+
or it stops, so following approaches its standoff stop-go rather than rolling in gently. The
distance deadband is what makes that tolerable.

**The real fix, not done today.** The class `vesc_twist_node` drives the VESC in **RPM mode**,
where a speed PID chases a setpoint and cannot hold low speeds. **Duty-cycle or current mode has
no speed loop to hunt** and typically goes much slower smoothly; `vesc_client` already exposes
`send_duty_cycle`. That means writing our own actuator node instead of using the class one,
which is the genuine answer to "why can't this car go slowly".

### Phone speech layer working (2026-08-26)

Primitive buttons wired, browser speech recognition attached, behaviour and target telemetry
pushed back to the phone at 5 Hz.

- **Buttons and speech converge on `/voice_cmd`**, so `behavior_node` stays the single place that
  knows what the car can do and a button cannot behave differently from the same word spoken.
- **Speech sends its top three ranked guesses.** `behavior_node` falls through to the next
  alternative when the top one is not a command, which recovers near-misses in a noisy room.
- **Firefox cannot do this at all.** It implements the Web Speech API's synthesis half and has
  never shipped `SpeechRecognition`; no flag fixes it. Chromium and Safari only. Worth stating in
  the writeup as a constraint that partly justifies the on-robot microphone path existing.

**Result: phone speech outperforms the on-board mic**, and is sometimes faster. Not surprising in
hindsight: the phone's microphone sits at the speaker's mouth with real noise suppression, while
the Samson is bolted inches from the Pi's cooler in a room measured at RMS 2786 of noise floor.
Google's recognition is also better than a 68 MB offline model.

That reframes the two paths honestly. **The on-board mic's value is that it needs no phone and no
network, not that it is better.** Phone is the primary input; the mic is the one that still works
when the phone is in a pocket or there is no connectivity.

### Boot to driving with no terminal (2026-08-26)

`deploy/doggobot.service` starts the container and the full stack at power-on
(`tools/install_service.sh` installs it). `tailscale serve` already persists across reboots, so
the URL is live as soon as the nodes are. Logs move to journald: `journalctl -u doggobot -f`.

**The stack starting is NOT the car being live.** Hektoras asked for an explicit gate, which is the
right call and better than what I first built:

**Arm gate.** The arbiter has a master enable, `/arm`, defaulting **off** at power-on. While
disarmed it publishes zeros regardless of what any source asks for. Verified: disarmed + forward
gives 0.0, armed + forward gives 0.365, and disarming mid-motion returns to 0.0 immediately.

Reasoning for a deliberate tap rather than arming on page load: a page can open by accident, be
restored by the browser, or sit in a background tab, and none of those should be able to move a
car. The bridge also **disarms when the last client disconnects**, so walking away leaves the car
inert rather than idle, and the page **disarms its UI when the link drops**, since it reflects
the arbiter's reported state rather than the last tap.

### The always-listening mic was driving the car

Found while testing the arm gate: a `forward` command produced **-0.365**. Not a sign error. The
log showed `"back" -> reverse` and `"back go" -> reverse`: **the on-robot microphone had
overheard talking and executed it.**

This is a design problem rather than a glitch. The command vocabulary is ordinary English (stop,
back, forward, wait, hold, stay, left, right, follow) and the mic listens continuously, so anyone
having a conversation near the car can drive it. The phone path never had this problem because
push-to-talk is itself the gate.

Fix: **a wake word, required per-source.** Mic commands must address the car by name
("doggo forward"); phone speech does not need it, because holding the button is already
deliberate and adding friction to the already-gated path buys nothing. Picovoice's free wake-word
tier was discontinued, so this is implemented as a prefix inside the existing constrained
grammar, which costs nothing and cannot be triggered by a word outside the vocabulary. The wake
word is accepted anywhere in the utterance, not only at the start, because recognisers routinely
prepend filler.

Verified per-source: mic "forward" ignored, mic "doggo forward" runs, phone "circle left" runs.

### Wake word: doggo -> rex -> atlas (2026-08-26)

Settled on **"atlas"**. Two syllables deliberately: a longer word gives the recogniser more
acoustic content than a one-syllable name, and "rex" additionally rhymes with a family of common
words (wrecks, checks, next, text). Both "doggo" and "rex" were tested working first, so this is
robustness rather than a fix.

Known residual risk, worth recording rather than forgetting: **"atlas" is also a Boston Dynamics
robot**, so it does come up in robotics conversation. Far lower risk than "rover" would have been
in the same room, but if phantom commands ever appear in the log, suspect that first.

**A check that did not work, recorded so it is not repeated.** I tried to verify candidate wake
words against the model's lexicon by building a grammar per word and watching for an
out-of-vocabulary warning. Vosk accepted every candidate without complaint, including invented
words, so the test proved nothing. The model ships its vocabulary compiled into `Gr.fst` with no
plain word list to grep. **The only reliable check is saying the word and seeing what comes
back.**

### Power cycle verified (2026-08-26)

Full cold boot tested: battery and power removed, restored, then straight to the phone. The
container, all seven nodes, and `tailscale serve` all came back on their own. **Powered on,
opened the app, tapped ARM, gave a command. No terminal involved at any point.**

This was the last unverified assumption in the startup path. `systemctl restart` had been working
all along, but that only proves the unit runs, not that Docker's restart policy, service
ordering, network-online, and tailscaled all sequence correctly from cold. They do.

---

## 2026-08-27 - Sequencing, video, and three real fixes

**Sequencing executor.** `behavior_node` runs an ordered list of steps, one at a time. Verified on
the car: forward at 0.0 s, circle_left at 2.1 s, reverse at 5.1 s, stop at 7.2 s.

Spoken chains work without an LLM: **"forward then circle left then stop"** splits on
`then` / `and then` / `after that`. A keyword split, not language understanding, but it covers
the common case with no latency and no network. Each step keeps its default duration.

**A chain that half-parses is refused entirely.** First implementation rejected the chain and
then fell through to single-command matching, so "forward then jump then stop" drove the car
forward. Executing a fragment of something asked for as a whole is worse than doing nothing, and
that is exactly how a robot ends up somewhere surprising. Now the whole utterance is refused and
logged.

**Condition hook is in but unwired.** A step may carry `{"until": {...}}`, read from
`/condition_state`. Nothing publishes that yet, so such a step falls back to its duration and
says so. The duration therefore doubles as a timeout on every condition, which matters: a
sequence waiting forever on a green marker it will never see is a car stuck mid-demo with no way
out.

**Video to the phone.** `perception_node` JPEG-encodes the tracker's own passthrough frame (so
the overlay always matches the image it is drawn on) and publishes `camera/compressed`; the
bridge serves it at `/stream.mjpg` as multipart MJPEG, which any browser renders in a plain
`<img>` with no client library, no WebRTC negotiation and no codec check. The app has a Video
On/Off toggle, off by default.

Encoding runs only when something is subscribed and at 8 fps against the pipeline's 12: not
watching costs the car nothing, and video should never take cores from the control loop.

### Three fixes, each found by something behaving oddly

**Follow no longer reverses**, and the deadband widened from 150 to 300 mm. With the throttle
floor at 0.365 there is no slow speed, so the loop is bang-bang: it overshot the standoff,
reversed, overshot the other way, and yo-yo'd around 1 m. Driving up and stopping is also better
behaviour on its own terms, since a car backing away from someone walking toward it reads as
skittish.

**Disarm now has a 10 s grace period.** The disarm-on-last-client-disconnect rule fired three
seconds into a running sequence when the phone's WebSocket dropped. Phone browsers close sockets
constantly (screen sleep, backgrounding, network blips). Walking away should still make the car
inert, so this is a delay with a cancel-on-reconnect, not a removal.

**ROS2 discovery is asynchronous, and publishing into it is silent success.** A test script
created a publisher and published about a second later; sometimes the far side had connected and
sometimes it had not, with no error either way. That intermittency is worse than a consistent
failure because it looks like a logic bug. Any script that starts, publishes and exits must wait
for `get_subscription_count() > 0` rather than sleeping and hoping.

### A process note on my own error

The duplicated video code that crashed `perception_node` at startup
(`ParameterAlreadyDeclaredException: ['video_fps']`) came from an edit that had partially applied
before an interruption. I assumed an interrupted tool call meant nothing was written. **Check
file state after an interruption instead of assuming it was atomic.**

---

## 2026-08-29 - Colour detection, conditional commands, LiDAR guard

### Colour detection

HSV thresholding in `doggobot/color.py`, run inside `perception_node` because only one process
can own the camera. Publishes `/condition_state` at 5 Hz, which the sequencer's `until` hook was
already waiting for, so this was a publisher rather than a rewrite.

**Red needs two hue bands.** OpenCV maps hue to 0-179 and red sits at *both* ends, roughly 0-10
and 170-179, so a single range cannot express it. This is the classic HSV mistake and it presents
as "red sort of works", which is worse than failing outright.

**Largest contour, not total pixel count.** A wall speckled with matching pixels should not
outvote an actual object.

**Thresholds are data, not code**: loaded from and saved to JSON, updated live over a topic. A
phone tab has per-channel sliders and tints matching pixels on the video feed, so tuning is done
by eye at the venue rather than by editing a file and restarting.

**Tuning is deferred to the venue.** The demo is indoors at 11:30 on Friday with room lighting
plus daylight through large windows, which means **mixed colour temperature**: the same target
reads a different hue depending on which source dominates where it stands. Thresholds tuned in a
bedroom will not transfer. Also worth doing then: lock the camera's white balance and exposure,
because auto-WB actively changes colour rendition as the car moves, which invalidates any fixed
threshold.

`color_react` test mode drives forward on green and reverses on red, continuously, from a button.
It exists so thresholds can be checked against real motion with the wheels up and without
speaking. Bounded at five minutes: an open-ended reactive mode is exactly what drives off a bench
while you are looking at your phone.

### Conditional commands

"forward until green" and "forward until you see green then circle left then stop" now parse
into conditional steps, with no LLM involved.

**An unrecognised condition is refused, not dropped.** The first version fell back to plain
keyword matching, so "forward until purple" drove the car forward for three seconds. Dropping a
condition you did not understand turns "drive until you see green" into "drive for three
seconds", which is a different and much worse instruction than the one given. Same principle as
the chain refusal added on 2026-08-27.

### LiDAR proximity guard

`safety_node`: `/scan` to `/safety_cmd`, finally giving the arbiter's safety input a publisher.
Covers the ~290 degrees the camera cannot see, which is the reason the LiDAR is on the car at all.

| Sector | Stop | Why |
|---|---|---|
| front | 0.45 m | **inside** the 1.0 m follow standoff |
| rear | 0.35 m | nothing else watches behind, and reversing is in the demo |
| side | 0.25 m | camera never sees them; tight because the car steers as it drives |

**Front must stay inside the follow standoff.** The person being followed is an obstacle as far
as the LiDAR is concerned, so a front threshold at or above the standoff would deadlock the
follow controller against the guard permanently.

**Publishes only while intervening.** The arbiter ranks safety above everything but the e-stop,
so a continuously publishing guard would veto the entire system forever. Silence plus the
arbiter's staleness timeout is what makes the veto momentary.

**Nth-smallest range, not the minimum**, so a lone spurious return cannot trip it. Spring-2023
Team 10 documented open areas producing phantom close points on this sensor class, which froze
their robot.

**Orientation was measured, not assumed.** `tools/lidar_sectors.py` prints a live compass so a
moving object can be told apart from furniture; a single snapshot cannot. Result:
`forward_offset_deg: 0.0`, the LiDAR's zero already points forward.

#### The circularity bug, worth remembering

The first version read `/cmd_vel` to decide which direction the car was travelling. But
`/cmd_vel` is the arbiter's **output**, which this node vetoes. Stop the car, the output goes to
zero, the guard concludes nothing is moving, releases the veto, the car lurches, repeat.

It now reads `/behavior_cmd` and `/teleop_cmd`: the arbiter's **inputs**, which are unaffected by
its own veto. **A safety system must observe intent, not an outcome it is already influencing.**

Verified on hardware: intent 0.365 forward, obstacle at 0.22 m, `control -> safety`, then
`clear` and `control -> behavior` once the path opened.

### The LLM slow path (2026-08-29)

`llm_node`: `/voice_unparsed` in, a structured command out on `/voice_cmd`. When the keyword
parser fails to match an utterance, `behavior_node` publishes the text rather than just logging
it, and this node may turn it into a sequence.

**A separate node, not inside `behavior_node`.** That node runs the control loop, and a blocking
network call inside it would stall the primitives. This way the fast path never waits on the slow
path.

**Self-hosted by choice.** Ollama on Rasputin (RTX 3070, 8 GB) reached over Tailscale, rather
than a vendor API. Two reasons. Everything else in the project already runs on hardware we
control, so the parser matching that is consistent rather than special. And as a demonstration,
"the language model runs on a machine I own" is a materially different claim from "I called an
API" is Hektoras's framing, and it is the right one.

**The schema is the safety mechanism, not the prompt.** Ollama constrains decoding to a JSON
schema whose `action` and `until_color` fields are enums of the primitives that actually exist,
so the model **cannot emit an action the car does not have**. Same trick as the Vosk grammar on
the microphone: rather than trusting a model to behave, make misbehaviour unrepresentable.

**It refuses rather than approximates.** The prompt requires `understood: false` for anything it
cannot express, and the test set includes "make me a sandwich" to check. Third time this
principle has come up: a wrong guess makes the car do something nobody asked for.

**It can only ever add.** Unreachable, slow, or nonsense responses all end in the utterance being
dropped, and the car behaves exactly as it does with no LLM at all. Verified: with Ollama not yet
installed, the node logs `llm unreachable` and everything else runs normally. The keyword path
covers every graded requirement on its own, so this tier must never become load-bearing.

Also: one request at a time. Queueing utterances would let the car act on something said several
seconds ago, which is worse than ignoring it.

#### Model choice, and why capability barely matters here

Considered Kimi K3 (2.8T parameters, MoE with 104B active, open weights, July 2026). It cannot
run on 8 GB by any route: even at 4-bit the weights exceed a terabyte, and MoE does not help
because all experts must be resident. It is an API model, which is the thing we were avoiding.

More usefully: **the parser's task is mapping words onto an enum that already exists**, and the
schema has already constrained the output space to seven actions and two colours. A frontier
model cannot do that better than a 7B, because there is no room to be better. Same reasoning that
made a 68 MB Vosk model adequate for the microphone.

Picked `qwen2.5:7b-instruct` (~4.5 GB at Q4): strong at instruction-following and JSON, leaves
headroom on the card, fast. `llama3.1:8b-instruct` is an equally reasonable swap, one string in
`config/llm.yaml`.

**Setup gotcha for whoever runs the host:** Ollama binds `127.0.0.1` by default. Set
`OLLAMA_HOST=0.0.0.0:11434` and restart it, or nothing off that machine can reach it. This is the
single most common reason a local model "works on my machine".

#### The LLM tier working (2026-08-29)

| Utterance | Parsed to | Time |
|---|---|---|
| "drive forward for five seconds then spin left twice" | forward -> circle_left -> circle_left | 0.8 s |
| "go until you see the green thing and then stop" | forward -> stop | 0.6 s |
| "back up a little bit and then do a figure eight" | reverse -> figure_eight | 0.4 s |
| "make me a sandwich" | **not understood** | 0.3 s |

All correct, including counting "twice" into two steps, mapping "spin left" onto a primitive that
is not named that, and refusing the nonsense rather than approximating.

**Two fixes were needed, and both are worth remembering.**

**The model was never slow, it was unloaded.** Cold: 50.9 s to load 4.7 GB into VRAM. Warm:
0.34 s. Ollama evicts after five minutes idle by default, which would have meant a 50-second wait
for the first command of every demo, and again after any pause. Fixed by keeping it resident
(`keep_alive`) and warming at node startup. This is the same shape as the "starting is not
running" throttle lesson: the first measurement described a state, not the steady state.

**`keep_alive` means different things depending on its JSON type.** A *string* is parsed as a Go
duration, so `"-1"` fails with `missing unit in duration`; the *number* `-1` means never evict.
The node now converts numeric-looking config values to a JSON number, so either spelling works in
YAML.

**Result worth stating plainly**: sub-second parsing on our own hardware. The whole voice stack
now runs on machines we own: speech offline on the Pi or in the phone's browser, detection on the
camera's VPU, language parsing on the desktop. Nothing about a spoken command leaves the network.

### Explicit LLM routing, and a prompt that describes mechanism (2026-08-29)

**"atlas listen ..." routes to the LLM and locks the keyword matcher out.** Hektoras's idea, and it
fixed a live bug rather than just adding convenience. Previously, saying a long sentence to the
mic let the grammar pass hear "atlas go right" inside it, match `circle_right`, and drive a six
second circle while discarding the rest. The grammar cannot represent a sentence it has no words
for, so it grabs the fragment it can. Explicit routing means the fast path never gets to interpret
part of something aimed at the slow path.

The implicit fallback remains: grammar hears nothing, free-form heard words with the wake word in
them, escalate. Forgetting "listen" degrades rather than fails.

**The free-form pass needed the same gate the grammar has.** Unconstrained recognition on an
always-on mic invents words from room noise ("surrender willing case", "i've never seen a
benign"), and each one was a needless LLM call. It now requires the wake word too. The grammar
never had this problem precisely because it cannot produce out-of-vocabulary words.

**A refused chain now escalates instead of being dropped.** Refusing a partially-parsed chain was
right when there was no slow path; with one, it was throwing away exactly the utterances the LLM
exists for. "spin right two times then reverse" was heard perfectly by the phone and binned.

#### The prompt bug: naming without describing

"go right for 5 seconds then left for 3 seconds" parsed to `forward -> circle_right`. Two errors:
direction words became `forward`, and the second duration was attached to the wrong step.

Cause: the system prompt listed the primitive *names* but never said what they physically do, and
this car has **no "turn right" primitive**. Turning is only expressible as driving in a circle.
Asked to map "go right", the model guessed. Rewritten to describe the mechanism ("there is no turn
and keep going straight: the only way this car changes direction is by driving in a circle"),
state that direction words mean circles, and that a duration belongs to the step it was spoken
with. All five test cases correct afterwards, sub-second.

**A test that cannot observe the thing that broke is not evidence.** The first run after the fix
showed all five action sequences correct and I nearly stopped there, but the summary printed only
action names, so it was blind to durations, which were half the bug. Now prints arguments.

### Battery, and a profile that was wrong for weeks

A pack ran flat enough to kill the car, and the charger then refused it. Root cause: the VESC had
a **3S** profile on a **4S** pack, putting the low-voltage cutoff near 9 V = **2.25 V per cell**,
so the protection that should have stopped the car near 12 V never fired. Flagged as a risk on
2026-08-26 and it materialised three days later.

Recovered with a stepped kick-start (2S briefly, 3S, then 4S). That is the standard technique and
it does bypass a protection that exists because charging a deeply discharged Li-ion can plate
copper internally. A considered decision, not a habit. **VESC corrected to 4S the same day.**

`tools/battery_check.py` now runs as a systemd `ExecStartPre`, so every boot logs pack voltage and
per-cell average. It runs in the only window where it can: `vesc_twist_node` holds `/dev/ttyACM0`
exclusively and publishes no telemetry, so once the stack is up the battery is unreadable.
Continuous monitoring needs our own actuator node, which is the same work that would unlock
duty-cycle mode for smooth slow driving.

**Lesson: a mis-set battery profile does not announce itself.** Everything worked normally for
weeks, and the failure landed on the one component with no way to complain.

### Container DNS: a stale file outliving the thing that made it wrong

`llm_node` failed with `Name or service not known` for `rasputin` while the host resolved it fine.
Docker captured `/etc/resolv.conf` when the container was **created**, before Tailscale owned DNS
on the Pi, so it listed only the ISP's resolvers and knew nothing about MagicDNS. Fixed by
pointing it at `100.100.100.100` with the tailnet search domain; Docker does not regenerate the
file once edited, so it persists across restarts but **is lost if the container is recreated**.
Documented in `docs/runbook.md` and the backup restore procedure.

### Tab-as-mode, turn-around, three-point turn (2026-08-29)

**Four tabs, and the tab IS the mode.** DRIVE is manual only: while it is open nothing autonomous
can move the car, and arriving there **cancels** whatever was running. AUTO carries follow, the
target panel and the primitives. VOICE and TUNE unchanged.

Cancel rather than warn, deliberately: a mode that silently lets a sequence continue is worse than
no mode, because the whole value is being able to glance at the screen and know the car will not
move on its own. `stop` and `release` are exempt from suppression, since refusing to stop in order
to enforce a safety mode would be absurd. A lock acquired while suppressed is released rather than
obeyed.

**`turn_around`**, which was a real gap: the proposal's mission statement says "turn around" and
there was no way to express it. A held full-lock circle for a measured time.

**`three_point`**, and I was wrong to say it was impossible. I claimed the car "has no
reverse-steer sequencing", but `reverse` sets steering to zero **because I wrote it that way**,
not because of any constraint. Added `rev_left`/`rev_right`, and a three-point turn is
`circle_right -> rev_left -> circle_right`, expanded into a sequence so it inherits cancellation
and timeouts. It also answers the turning-radius complaint from the ground test: **a reverse leg
sidesteps the Ackermann limit that no steering gain can change**, which matters indoors.

### Video is capped by the detector, and trying to fix it broke everything

Asked for 30 fps, measured **12.4**, identical to `/target_state`, because video comes from the
tracker's passthrough, so every video frame is a detector frame. The 20 fps cap I had written was
meaningless.

Tried adding a second `cam.requestOutput()` to bypass the NN. **It silently broke the entire
perception pipeline**: it constructed, logged `camera pipeline started`, and produced no tracker
output at all, taking following and colour detection down with it. The failure then hid behind
`X_LINK_DEVICE_ALREADY_IN_USE` from the retry loop colliding with the dying pipeline. Reverted.

**`camera pipeline started` means constructed, not producing.** I trusted a log line that only
proved the easy half. Full-rate video needs a different approach than a second output on this
camera and is not worth risking a working perception path over.

### Manual now outranks the LiDAR guard

Hektoras found the car could not be driven out of a tight spot: with an obstacle 0.2 m off one
flank, `_hazard()` vetoed **every** direction including the reverse that would free it, because
the flank sectors apply to any motion.

The fix is authority, not geometry. Arbiter priority is now
`arm -> e-stop -> teleop -> safety -> behaviour`. **The guard exists to catch what the autonomy
cannot see; a person with eyes on the car and a kill switch has context no proximity sensor has,
and a guard that blocks escape protects nothing.** The e-stop still sits above both.
`safety_outranks_teleop: true` restores the old ordering.

### Distance and angle commands

"go forward one metre then reverse half a foot" and "go right at a 30 degree angle" now parse,
with unit conversion handled in the prompt (half a foot -> 0.15 m).

**Dead reckoning, open-loop by necessity.** The VESC reports a tachometer, but the class
`vesc_twist_node` holds the serial port exclusively and publishes no telemetry, so wheel travel is
unreadable while the stack runs. Closing that loop means replacing the class actuator node, which
is the same work that would give continuous battery voltage and duty-cycle slow driving. Not
before the demo.

So distance is time multiplied by a rate, and **both rates are guesses until measured**:

| Parameter | Now | How to measure |
|---|---|---|
| `metres_per_second` | 0.9 | run `forward` for a known time, tape-measure it, divide |
| `degrees_per_second` | 60 | run `turn_around`, see how far the nose swung, divide by time |

Until then "forward one metre" is confidently wrong. Both change with surface, slope and pack
charge. The same session settles `turn_around_seconds` and the three three-point legs.

## 2026-08-30 - The camera pan axis, and the follow cascade

Away from the car, so everything here is bench work, code and simulation. The servo was on the
Victus with a spare 2S pack.

### The bus scan found nothing, and the reason was the first thing on the list

Flashed `esp32_sts_bringup` clean and the scan came back `nothing on the bus`. The sketch's own
error text lists four suspects in order, and the answer was suspect number one: TX and RX
crossed. Swapping them in firmware found the servo immediately.

```
found ID 1  pos=1  volts=7.8
```

Working mapping is adapter **TX to GPIO 17**, adapter **RX to GPIO 16**. The naming reads
backwards on purpose: `RX_PIN` is the pin the ESP32 receives on, so it wires to the adapter's
transmit. The docs said the opposite and are now corrected.

Worth noting because it is the cheap version of the lesson: the diagnostic paid for itself.
Writing the suspects into the failure message, in likelihood order, turned a wiring hunt into
one two-line edit.

### Run-mode firmware

`esp32_sts_bringup` is a console for a human; `esp32_pan` is a line protocol for `pan_node`. It
sets angles and reports angles and decides nothing, because a microcontroller that second-guesses
its host is a second controller fighting the first, which is exactly the failure `arbiter_node`
exists to prevent, moved one layer down where it is harder to see.

Angles cross the wire, never encoder counts. That the STS3215 puts centre at 2048 is an
implementation detail of one file.

`tools/pan_console.py --selftest` commands 0, +/-30 and +/-60 and reports measured against
commanded:

| target | reached | error | settle |
|---|---|---|---|
| +30 | +29.6 | -0.4 | 0.50 s |
| -60 | -58.9 | +1.1 | 1.00 s |

Zero bus errors, 7.9 V steady, roughly 120 deg/s. The self-test reports measured-against-commanded
on purpose: "the servo moved" and "the servo went where it was told" are different claims and only
the second one is worth anything to a control loop.

### The actual design question: how do steering and camera angle combine

They do not combine. They cascade.

| loop | error | actuator |
|---|---|---|
| inner | `x`, bbox offset | pan servo, keeps the target framed |
| outer | bearing | steering, points the chassis where the camera looks |

The camera chases the target, the car chases the camera. The bearing carries it:

    bearing_deg = pan_deg + x * half_fov_deg
    err_steer   = bearing_deg / half_fov_deg

The property that made this the right shape: when `pan_deg` is zero, `err_steer == x`, which is
**exactly** the old fixed-camera controller. A dead servo, an unplugged ESP32 or `use_pan: false`
all fall back to the previous behaviour with the previous gains. The degraded path is the
well-tested path, not a special case that only runs when something is already broken.

### Simulated before it touched the car

`tools/sim_cascade.py` stubs rclpy and drives the **real** `FollowNode`. A test that
reimplements the thing it tests proves only that two copies of the same mistake agree.

| scenario | fixed camera | cascade |
|---|---|---|
| approach from 28 deg off | camera 2.8 deg off | 0.3 deg |
| tight turn, 31 deg at 1.7 m | 16.6 deg off | 0.6 deg |
| person circles a car stopped at the standoff | **out of frame 89%** | **0%** |

The last row is the justification for the hardware, and the sim taught it rather than confirming
it. My first pass gated on "is the chassis aimed at the target" and the tight-turn case failed for
both configurations. That was not a controller bug: once the car reaches the standoff it stops,
and a non-holonomic vehicle cannot change heading while stopped. From that instant the chassis has
no authority over framing at all, and the camera is the only thing that can still aim. The
acceptance criterion was wrong, not the code.

Two scenarios deliberately invert a sign and are required to diverge, so the suite is known to be
able to see the failure it claims to rule out.

### The trap that would have cost an afternoon

`x` describes a frame captured about 100 ms ago. The pan angle read *now* is not the angle the
camera had then. At 120 deg/s that is 12 degrees of fiction injected into the bearing, larger than
the errors being controlled, and it presents as a mistuned gain that no amount of tuning fixes.

`follow_node` keeps a ring buffer of `(timestamp, angle)` and looks up the angle at the frame's own
stamp. A related detail found while wiring it: `perception_node` stamps `/target_state` at
**publish** time, not capture time, so `capture_lag_s` offsets the lookup.

The inner loop integrates on the last **commanded** angle rather than the measured one, because
the servo takes 0.5 s to settle while frames arrive every 80 ms; correcting from the measured
angle re-issues corrections the servo is still executing and the axis crawls. A slip check
resyncs to measurement if the two drift more than 15 degrees, which is what a stall or a slipped
mount looks like.

### Deployment traps, found before they bit

**The LiDAR is already on `/dev/ttyUSB0`.** Adding a third USB serial device to a Pi that already
has the VESC and the LiDAR is a race for kernel names, and if the ESP32 wins that number the LiDAR
driver opens the servo bus and the safety node goes blind. `deploy/99-doggobot-serial.rules` keys
on the FT232R's own serial, A5069RR4.

**A container cannot be given a device it was not started with**, so the ESP32 means recreating
it, and a recreate discards the `/etc/resolv.conf` DNS patch and the `ROS_DOMAIN_ID=66` line, both
of which have already cost time once. `tools/setup_container.sh` re-applies them. It deliberately
does not create the container: that is coursework.

### Also corrected

`docs/hardware.md` said the main pack is 3S. It is 4S. That is the same wrong number that was once
set in VESC Tool, which put the low-voltage cutoff at 2.25 V per cell.

### Still guesses

`half_fov_deg` is the OAK-D Lite's half-HFOV as a placeholder, but `x` is normalised across the
detector's **letterboxed** input, so degrees-per-unit-x has to be measured. `capture_lag_s`,
`invert` and `centre_offset_deg` all need the real mount. None of them can be settled without the
car.
