TheDjabra/doggobot/config/follow.yaml

follow_node:
  ros__parameters:
    # --- steering ---
    # Starting point is the car's own lane-following calibration
    # (ros_racer_calibration.yaml: Kp 0.2 / Ki 0.0 / Kd 0.1). Same servo, same
    # steering geometry, same actuator scale. The error SOURCE differs: a bbox
    # centre at ~12 fps is noisier than a lane centroid, so expect kd to want
    # lowering if the steering chatters. The D term is already low-passed.
    # RAISED from the lane-following 0.2 after measuring on the car: with x
    # normalised to +/-1 and steering clamped at +/-0.8, kp 0.2 meant a target at
    # the very edge of frame commanded only a quarter of the available steering
    # (measured: x=+0.455 -> steer=+0.078). The plant is the same as lane
    # following but the error signal's SCALE is not: a lane centroid deviates a
    # little, a tracked person can sit at the frame edge.
    # 0.45, down from 0.6. Not a taste change: err_steer is bearing/half_fov,
    # and half_fov was corrected from 34.5 to a measured 25.2, so the SAME
    # bearing now produces 1.37x the steering it used to. 0.6 was tuned before
    # that. At 0.6 a 25 degree pan already saturates the steering; at 0.45 it
    # takes about 40 degrees, which is the behaviour that was there before the
    # measurement changed the scale underneath it.
    kp_steer: 0.45
    ki_steer: 0.0
    kd_steer: 0.1
    steer_deadband: 0.05      # ignore <5% off-centre; stops hunting
    max_steer: 0.7            # inside the arbiter's 0.8 clamp

    # --- throttle ---
    standoff_mm: 1000.0       # provisional. Refine by measuring where detector
                              # confidence peaks, once testing on the ground.
    kp_throttle: 0.0004       # err is in mm: 1000 mm error -> 0.4, clamped to max
    kd_throttle: 0.0001
    throttle_deadband_mm: 300.0   # +/-30 cm counts as "at the standoff"
    # 0.365, not the measured 0.25 minimum. Hektoras's call after driving it: 0.25
    # is where smoothness BEGINS, and sitting right on that edge leaves nothing
    # for the humps (carpet seams, a slight incline, a wheel catching). 0.365 also
    # lands on the class's own min_throttle, i.e. the slowest speed this platform
    # is calibrated to drive.
    #
    # Consequence: with a ceiling of 0.382 the throttle loop now has almost no
    # range to modulate within, so approach is effectively bang-bang: at speed,
    # or stopped in the deadband. The PD term barely matters for throttle now.
    # Steering is unaffected and still fully proportional.
    throttle_floor: 0.365      # MEASURED smooth floor. NOTE the consequence: the
                              # car cannot follow slowly. It moves at 0.25+ or it
                              # stops, so approach is stop-go rather than a gentle
                              # roll-in. The distance deadband is what makes that
                              # acceptable.
    max_throttle: 0.38        # the platform's calibrated ceiling
    # Reverse OFF (2026-08-27, observed on the ground). With the throttle floor
    # at 0.365 there is no slow speed, so the loop is bang-bang: it overshot the
    # standoff, reversed, overshot the other way, and yo-yo'd around 1 m. Without
    # reverse it drives up and stops, which is also the better behaviour on its
    # own terms: a car backing away from someone walking toward it reads as
    # skittish. The deadband was widened to 300 mm for the same reason, so the
    # car does not restart every time the target shifts weight.
    allow_reverse: false
    max_reverse: 0.382         # lower than max_throttle on purpose. Approaching and
                              # retreating are not symmetric: someone stepping
                              # toward the car makes a big negative error fast, and
                              # full-authority reverse there reads as bolting
                              # rather than yielding. Measured -0.24 before this cap.

    target_timeout_s: 0.5     # perception dying must not read as "target centred"

    debug_hz: 2.0             # log x, z, err, steer, throttle from one message.
                              # Set 0 for quiet running.

    # --- pan cascade (added 2026-08-30) ---
    # The camera is an inner loop that keeps the target framed; the car is an
    # outer loop that points the chassis where the camera looks. See the module
    # docstring in follow_node.py for why the bearing is computed the way it is.
    #
    # Verified in simulation before any of it touched the car
    # (tools/sim_cascade.py, 7/7): with the car stopped at the standoff and a
    # person walking around it, a fixed camera loses them for 89% of frames and
    # the lock with it. The pan axis loses 0%.
    use_pan: true

    # NOT the camera's spec-sheet HFOV. `x` is normalised across the DETECTOR's
    # letterboxed input, so the degrees-per-unit-x has to be measured: put the
    # target at a known bearing, read x from /target_state, divide. 34.5 is the
    # OAK-D Lite RGB half-HFOV and is a placeholder until that is done.
    # MEASURED 2026-09-02, not taken from the camera spec. 25.2, two runs
    # agreeing to 0.1 deg, worst residual 0.062 in x (about 1.5 deg).
    #
    # The spec-sheet 69 deg HFOV describes the LENS. It is not this number,
    # because DetectionNetwork.build(camera, ...) requests its input with the
    # default resize mode, which is CROP: the detector sees a 416x416 CENTRE
    # CROP of the sensor, so x = +/-1 spans much less than the full frame. The
    # measurement lands between the two crop geometries predicted beforehand
    # (21.1 for 16:9, 27.3 for 4:3), which is the expected place for it.
    #
    # Method: with a stationary target, x = (bearing - pan)/half_fov, so
    # dx/dpan = -1/half_fov. The pan axis is encoder-verified over +/-90, which
    # makes it a ruler we already trust. No tape and no marked bearings.
    # tools/measure_fov.py reproduces it in about 20 seconds.
    half_fov_deg: 25.2

    # The camera command is an ABSOLUTE angle anchored to the measured one, not
    # an increment onto the last command, so it cannot ask for a position beyond
    # the target's true bearing. That is what makes a high gain safe here: 1.0
    # would aim exactly at the target, and only the frame latency stops it being
    # usable. Swept in tools/sim_cascade.py --ki-sweep against a servo model
    # with the measured 120 deg/s limit and 0.25 s settling:
    #
    #   kp_pan   oscillations   worst aim error, person crossing fast
    #   0.55           1              7.0 deg
    #   0.85           1              4.5 deg     <- here
    #   1.00           8              3.7 deg     unstable
    #
    # For comparison the OLD incremental loop at 0.55 oscillated 9 times.
    kp_pan: 0.85
    kd_pan: 0.05
    # Integral stays OFF. It was tried: a moving person is a ramp and a
    # proportional loop lags one, so an integrator looks like the fix. It made
    # both the lag AND the oscillation worse at every value, because the lag is
    # not a steady-state error, it is the servo physically unable to keep up.
    ki_pan: 0.0
    i_limit_pan: 0.6
    pan_anchor_to_measured: true
    pan_limit_deg: 70.0     # hard ceiling is 90; this stays well inside it
    pan_deadband: 0.04
    pan_slip_deg: 15.0  # commanded vs measured gap that means a stall or a
                        # slipped mount, and forces a resync to reality
    pan_stale_s: 0.5

    # Measure this. It is the age of a frame when follow_node sees it, and at a
    # 120 deg/s slew every 100 ms of it is 12 degrees of fiction in the bearing.
    capture_lag_s: 0.08

    # Above this bearing, stop and turn rather than drive. A car cannot strafe,
    # so closing on a target 50 degrees off the nose mostly makes the angle worse.
    align_before_drive_deg: 50.0
