TheDjabra/doggobot/tools/test_llm.py

#!/usr/bin/env python3
"""Exercise the LLM slow path with utterances the keyword parser cannot handle.

  docker exec Doggobot bash -c "source .../env.sh && python3 .../tools/test_llm.py"
"""
import json
import sys
import time

import rclpy
from rclpy.node import Node
from std_msgs.msg import String

CASES = [
    # Direction words must become circles, and each duration must stay with its
    # own step. Both were wrong before the prompt was rewritten.
    ('go right for 5 seconds then left for 3 seconds',
     'circle_right(5) -> circle_left(3)'),
    ('spin right two times then reverse',
     'circle_right -> circle_right -> reverse'),
    ('drive forward for five seconds then spin left twice',
     'forward(5) -> circle_left -> circle_left'),
    ('go until you see the green thing and then stop',
     'forward(until green) -> stop'),
    ('go forward one metre then reverse half a foot',
     'forward(1m) -> reverse(0.15m)'),
    ('go right at a 30 degree angle', 'circle_right(30deg)'),
    ('make me a sandwich', 'not understood'),
]


def main():
    rclpy.init()
    node = Node('llm_tester')
    pub = node.create_publisher(String, 'voice_unparsed', 10)
    seen = []
    node.create_subscription(String, 'llm_state',
                             lambda m: seen.append(json.loads(m.data)), 10)

    t0 = time.time()
    while pub.get_subscription_count() == 0 and time.time() - t0 < 10:
        rclpy.spin_once(node, timeout_sec=0.05)
    if pub.get_subscription_count() == 0:
        print('llm_node is not subscribed to /voice_unparsed. Is it running?')
        return 1

    for text, expected in CASES:
        print(f'\n>>> {text!r}')
        print(f'    expect: {expected}')
        seen.clear()
        pub.publish(String(data=json.dumps({'text': text, 'source': 'test'})))
        t0 = time.time()
        while time.time() - t0 < 20:
            rclpy.spin_once(node, timeout_sec=0.1)
            if seen and seen[-1]['state'] not in ('thinking',):
                s = seen[-1]
                print(f'    {s["state"]}  {s.get("detail", "")}  '
                      f'({time.time() - t0:.1f}s)')
                break
        else:
            print('    timed out with no response')

    node.destroy_node()
    rclpy.shutdown()
    return 0


if __name__ == '__main__':
    sys.exit(main())
