TheDjabra/doggobot/(commit log)

2026-08-25 arbiter_node: sole /cmd_vel publisher with priority, staleness timeouts, and clamping
2026-08-25 tools: arbiter logic test harness (no actuator required)
2026-08-25 Correct throttle-clamp units, lower default speed limit, add drive.launch.py
    [arbiter_node.py]
2026-08-25 tools: direct VESC probe for diagnosing a silent motor
2026-08-25 Measured throttle floor; restore 0.382 ceiling to match the car's calibration
2026-08-25 tools: safety validation for deadman and e-stop with the motor running
2026-08-25 docs: measured drive characteristics, 4S battery, safety validation results
2026-08-25 voice_bridge_node: phone control surface with drive pad, kill switch, PTT skeleton
2026-08-25 Fix name collision with rclpy Node.clients property
    [voice_bridge_node.py]
2026-08-26 docs: LiDAR role as complementary coverage, top mounting, GPS dropped
2026-08-26 tools: probe whether the v2-era blob runs under depthai v3
2026-08-26 probe: run the detector through the generated NN Archive
2026-08-26 probe: allow confidence threshold override
2026-08-26 tools: print detection boxes to distinguish duplicates from real multiples
2026-08-26 probe: allow archive override
2026-08-26 tools: full perception probe, stereo depth + spatial detection + tracker
2026-08-26 perception: ROBOTICS preset and median filter off, OAK-D Lite SIPP memory limit
2026-08-26 perception: request an explicit fps from the camera
2026-08-26 perception probe: isolate stereo vs tracker cost
2026-08-26 perception probe: run tracker host-side, selectable stereo preset
2026-08-26 tools: power stress test, perception under motor load
2026-08-26 build log: power stress test clean under motor load
2026-08-26 perception_node: camera to a single locked target on /target_state
2026-08-26 follow: raise steering gain for the error scale, cap reverse authority
    [follow.yaml, follow_node.py]
2026-08-26 follow: do not print a fake error when depth is invalid
    [follow_node.py]
2026-08-26 all.launch.py: the only stack with both the follow loop and the kill switch
2026-08-26 App: FOLLOW/RELEASE button and live target readout; no silent re-lock after loss
2026-08-26 build log: follow loop confirmed on the ground; turning-radius analysis
2026-08-26 behavior_node: forward, reverse, circle left/right, wait, stop, follow-as-primitive
    [behavior.yaml, behavior_node.py, follow_node.py]
2026-08-26 stt_node: offline Vosk speech from the on-board mic
2026-08-26 stt_node: negotiate audio format, downmix and resample if the device refuses
2026-08-26 vosk model lives under the bind mount; add fetch script
2026-08-26 tools: offline mic and Vosk probe
2026-08-26 stt probe: countdown, rms, chunked decode
2026-08-26 stt probe: capture native rate, resample in software
2026-08-26 Phone layer: primitive buttons, browser speech with alternatives, behaviour readout
2026-08-26 tools: measure where the drivetrain becomes smooth
2026-08-26 Raise throttle floor to the measured SMOOTH threshold of 0.25, not the start threshold
2026-08-26 build log: throttle floor corrected to the measured smooth threshold
2026-08-26 Throttle floor 0.365 with margin over the humps; guard against floor exceeding ceiling
2026-08-26 build log: phone speech layer, and it outperforms the on-board mic
2026-08-26 deploy: systemd unit so the stack starts itself at power-on
2026-08-26 Arm gate: the car powers on disarmed and obeys nothing until armed from the app
2026-08-26 build log: boot-to-driving, arm gate, wake word
2026-08-27 build log: cold power cycle verified, boots to phone control unattended
2026-08-27 Grace period before disarming; a dropped socket was killing running sequences
2026-08-27 Video feed to the phone; follow no longer reverses
    [follow.yaml, follow_firstrun.yaml, follow_node.py, perception_node.py, voice_bridge_node.py]
2026-08-27 Fix duplicated video code from a partially-applied edit
    [perception_node.py]
2026-08-27 Spoken sequences: chain primitives with 'then'
2026-08-27 tools: verify spoken chain parsing
2026-08-27 Refuse a whole chain if any step fails to parse, never execute a fragment
    [behavior_node.py]
2026-08-29 color_react test mode: forward on green, reverse on red, from a button
    [behavior.yaml, behavior_node.py]
2026-08-29 safety_node: LiDAR proximity guard on the arc the camera cannot see
2026-08-29 lidar_sectors: live readout so a test object can be told from furniture
2026-08-29 build log: colour detection, conditional commands, LiDAR guard
2026-08-29 Camera exposure and white balance lock for colour tuning at the venue
2026-08-29 Escalate refused chains to the LLM; gate the free-form pass behind the wake word
2026-08-30 battery_check: log pack voltage at every startup
2026-08-30 build log: explicit LLM routing, prompt fix, battery incident, container DNS
2026-08-30 Actually add the raw camera output; slow the pipeline retry
2026-08-30 Revert raw camera output: a second requestOutput silently killed the pipeline
    [perception_node.py]
2026-08-30 firmware: ESP32 port of the STS3215 bring-up console, and the pan-axis design note
2026-08-30 firmware: board identified as ESP32-S3 behind FT232R; pin caveats
2026-08-31 firmware: verified pin mapping and bench bring-up result
2026-08-31 pan axis: run-mode firmware, pan_node, and the follow cascade
    Camera pan as a cascade rather than a second controller on the same error:
    the camera keeps the target framed (inner loop), the car points the chassis
    where the camera looks (outer loop). With pan at zero the bearing collapses to
    the old fixed-camera error, so a dead axis degrades to the previous behaviour
    with the previous gains.
    - firmware/esp32_pan: line protocol, angles not encoder counts, hard clamp
    - pan_node: sole serial writer, publishes measured angle plus an ok flag
    - follow_node: bearing cascade, ring buffer for the stale-angle trap,
    cos(bearing) throttle scaling and an alignment gate
    - behavior_node: sole /pan_cmd p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
    [behavior.yaml, behavior_node.py, esp32_pan.ino, follow.yaml, follow_node.py, pan.yaml]
2026-09-01 llm: count-the-steps rule, fixes a dropped final step
    Found on the car: 'go forwards for 3 seconds then backwards for 3 seconds
    then steer left then right then left then right' parsed to five steps, not
    six. The trailing circle_right was silently dropped.
    Deterministic at temperature 0 (3/3 runs) and knife-edge: every one-word
    variation of that sentence parses correctly, as does the same six steps
    worded differently, and appending 'then stop' gives a correct 7/7. So it is
    a model failure on one token sequence, not a prompt-design flaw. max_steps
    is 8, so the clamp was not involved.
    The rule alone fixes it, with no example of the failing sentence, which
    rules out overfitting: 10/10 on a set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
    [llm_node.py]
2026-09-01 safety: hysteresis on the LiDAR guard, it was chattering
    Found on the car: 16 stop/clear cycles in one minute, which a 3 second
    command feels as being chopped into fragments. _hazard() was a bare
    threshold compared at 20 Hz, so an object sitting near the stop distance
    dithered across it and toggled the guard every tick. Each blocked tick
    publishes a zero Twist, so the car got move/stop/move/stop.
    Adds a release margin (0.07 m) and a minimum block time (0.4 s). Both only
    ever DELAY a release: the distance at which the guard intervenes is
    unchanged, so this cannot make it stop later than before.
    Measured offline against the real SafetyNode (tools/test_safety_hysteresis.py,
    via the new tools/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
2026-09-01 safety: phone override for the LiDAR guard
    On a stand the guard measures the bench and vetoes every command. Adds a
    Lidar Guard button below KILL, wired phone -> /safety_enabled -> safety_node.
    Built as an override rather than an off switch:
    - defaults to on and BOOTS on, so a restart or crash never leaves the car
    silently unguarded
    - re-enabled automatically when the last client disconnects, alongside the
    existing disarm, because whoever switched it off has walked away
    - the guard keeps RUNNING while overridden; it still computes and reports
    what it would have stopped for, so the page shows 'would stop: right'.
    Only the veto publish is withheld, so the operator can see what they ar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
    [safety.yaml, safety_node.py, test_safety_guard.py, voice_bridge_node.py]
2026-09-01 pan: hard +/-90 degree travel ceiling, enforced at four layers
    Operator instruction 2026-09-01. The axis free-spins and the camera ribbon
    is what is at risk, so the bound is enforced independently rather than
    configured once:
    - firmware ABS_LIMIT_DEG plus a static_assert, so widening the working
    clamp is a BUILD FAILURE, not something discovered by watching the cable
    - pan_node clamps limit_deg to 90 and logs an error if a config asks for more
    - behavior_node's two loose 90.0 literals become a named PAN_CEILING_DEG
    - pan_console's self-test clamps its own angles: a test that relies on the
    thing it is testing to keep it safe is not a safe test
    Working clamps stay well inside: firmware 8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
    [behavior.yaml, behavior_node.py, esp32_pan.ino, follow.yaml, follow_node.py, pan.yaml, pan_console.py, pan_node.py]
2026-09-01 look primitives: LLM vocabulary, drive-tab presets, udev for the new board
    - llm_node learns look_left / look_right / look_forward with a degrees
    argument, so 'look 45 degrees to the right' parses. The prompt spends most
    of its new words separating LOOKING from DRIVING, because the risk of
    adding these is that 'go right' starts meaning the camera.
    Tested against the live model: 15/15 exact, including 'go right' ->
    circle_right and 'turn right' -> circle_right unchanged.
    - drive tab gets a seven-way preset row (60/45/30 each side plus Fwd)
    alongside the existing slider, so a look is one tap.
    - udev now matches BOTH pan boards. The one on the car is an ESP32-S3 with
    native USB (3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
2026-09-01 pan firmware: boot limp, and learn mechanical zero
    setup() enabled torque and commanded 0 degrees, so every power-up and every
    reflash drove the axis to whatever the encoder calls centre, regardless of
    how the horn is clocked in the bracket. On a mounted camera that is a yank
    on the ribbon. Magnus caught it before the mount went on.
    - boots with torque OFF and no target. It comes up limp and waits.
    - 'e 1' now holds the angle it is ALREADY at, read back from the encoder,
    rather than driving to targetDeg. Engaging torque must not itself be a
    movement command.
    - new 'o <deg>' hands the firmware mechanical straight-ahead, so its +/-80
    clamp is measured from where the camera actually poin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
2026-09-02 pan: zero in the servo's EEPROM, not in software
    Magnus pointed out the servo can be zeroed in hardware, the way the turret
    was done, and he was right: I was building a software offset around a
    problem the servo already solves.
    The horn fits in 14.4 degree steps, so mechanical straight-ahead never lands
    on encoder centre; on this mount it was 128 degrees out. Carrying that as a
    software offset does not work, because the encoder covers exactly ONE turn:
    at 128 degrees out there were only ~52 degrees of travel left on the
    positive side before the count passed 4095 and WRAPPED rather than clamped.
    'z' calls CalibrationOfs, which writes the current position into EEPROM as
    2048. Done on the car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
    [esp32_pan.ino, pan_console.py]
2026-09-02 pan_node: find the servo by USB serial, never by probing
    The udev symlink exists on the host but not inside the container, which gets
    its own /dev. So the pan axis is /dev/ttyACM1 in there, and the VESC is
    /dev/ttyACM0. Trusting the name means one boot-order swap away from writing
    'p 30' into the motor controller.
    Resolved from sysfs by the ESP32's USB serial (10:20:BA:0D:FA:C8), which is
    read-only and opens nothing. That matters: merely OPENING the VESC's tty
    asserts DTR and can reset it, so 'try each port and see which answers' is
    not an acceptable discovery method on this vehicle. The banner check stays
    as a second gate on whatever sysfs picked.
    [pan.yaml, pan_node.py]
2026-09-02 behavior: look keywords must be matched before the drive ones
    Found on the car: 'look forward' logged as "look forward" -> forward. The
    camera command was driving the CAR. _match is first-wins over a SUBSTRING,
    'look forward' contains 'forward', and the drive primitives were listed
    first, so the look entries were unreachable.
    Silent and dangerous: a real primitive runs, just not the one asked for. On
    a stand that is nothing; on the floor 'look forward' drives away.
    - look_left / look_right / look_forward moved to the front of KEYWORDS, with
    the ordering marked as load-bearing.
    - tools/test_keywords.py checks the 21 phrases AND sweeps the whole table for
    shadowed entries, so any future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
2026-09-02 stop_stack: kill pan_node too, and keep ModemManager off the servo port
    A pan_node from an earlier launch survived a service restart, because this
    list predated the node. It matters more than a lingering process usually
    would: pan_node holds a serial port, so the orphan locked the replacement
    out and the new instance looped on 'device reports readiness to read but
    returned no data (multiple access on port?)'. The camera simply never moved,
    with no error that named the cause.
    Also tags the pan device ID_MM_DEVICE_IGNORE. ModemManager is running on
    this Pi and probes new ttyACM devices for a modem, which means writing AT
    commands at a servo controller and holding the port while it does it.
2026-09-02 docs: pan axis zeroing procedure and the native-USB board
2026-09-02 tools: guided motion calibration
    metres_per_second and degrees_per_second are guesses, so every distance and
    angle command is confidently wrong. This measures them.
    Two things it does that measuring by hand does not:
    - Watches /obstacle_state during each run and DISCARDS the sample if the
    LiDAR guard cut in. Otherwise the car stops early, the tape reads short,
    and the calibration is quietly wrong in a way nothing later explains. The
    car's left sector is currently 0.22 m against a 0.25 threshold, so this is
    not hypothetical.
    - Runs two durations and separates startup dead time from the steady rate.
    If the car needs a moment to break away, distance is not proportional to
    time and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
    [calibrate_motion.py]
2026-09-02 behavior: measured motion calibration, with a coast term for distance
    Tape measure and timed turns on the car, 2026-09-02.
    FORWARD, three runs: 1.0s->31in, 1.4s->40in, 1.8s->51in. The longer run
    averaged SLOWER, which is the signature of a constant offset rather than a
    rate error: the car coasts after the command ends. Fitting
    distance = rate*time + coast gives 0.635 m/s and 0.144 m, worst residual
    0.7in across a 51in run. The third point was predicted at 41in before it was
    measured, and came back 40in.
    That term is most of the error at the distances actually demoed indoors.
    Dividing by a rate alone, a 0.3 m command travelled 0.45 m: fifty per cent
    over, and visibly wrong on camera. Durati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
    [behavior.yaml, behavior_node.py]
2026-09-02 pan_node: do not assert DTR/RTS, it was knocking the ESP32 offline
    Found the pan axis dead: the board enumerated fine, USB serial matched, and
    it emitted nothing at all. A hard reset brought the firmware straight back,
    so the board was being held in a non-running state rather than crashing.
    Cause: this board has NATIVE USB, and particular DTR/RTS combinations are
    how an ESP32-S3 is put into download mode. pyserial asserts DTR on open by
    default, so every reconnect attempt re-applied the thing that broke it, and
    the 5-second retry loop turned a transient into a permanent outage.
    Now opens with dtr and rts explicitly false, applied before open() so they
    take effect at open time, plus exclusi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
    [pan_node.py]
2026-09-02 behavior: search sweep to reacquire a lost target
    When a follow lock drops the camera now waits, then sweeps to find the
    target again, starting toward the side it was last seen on because that is
    where it most likely still is.
    The sweep is the visible half and the easy half. The half that matters is
    the lock request: perception clears want_lock when a target is REMOVED
    (relock_on_loss is false), so a camera that swept beautifully and never
    asked for a lock again would find nobody, and would look exactly like a
    camera that is working. Search re-requests it, and releases it on timeout.
    - 2 s grace before sweeping. A lock often drops for a fraction of a second
    when someone turns or is brief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
2026-09-02 behavior: disarm stops the head too, and make sweep coverage observable
    Reported: the camera kept moving after a disarm. behavior_node never
    subscribed to /arm at all, so disarming gated the motors at the arbiter
    while this node carried on driving the camera. The wheels stopped and the
    head kept hunting, which is not what anyone means by disarmed.
    Disarm now ends any search, clears a manual look, cancels a sequence, stops
    the active primitive, parks the camera forward, and gives the lock back.
    The lock release initially only fired when active was 'follow'. During a
    search active is None even though search has RE-REQUESTED the lock, so a
    disarmed car was left ready to grab the next person w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
2026-09-02 perception/behavior: stop waiting out the tracker before searching
    Reported: the bounding box lingers on an empty doorway after the person
    leaves, and the sweep starts late. Both are the same cause. The DepthAI
    tracker keeps a LOST tracklet alive for a long time, perception only drops
    the lock on REMOVED, and the 2 s search delay was therefore stacked on top
    of the tracker's own timeout.
    Two changes:
    1. tracklet_max_lifespan, 15 frames (~1.2s at the NN rate). It is a real
    tradeoff, not a free win: this is also what bridges a brief occlusion, so
    too short and a person turning sideways becomes a new id.
    2. The search clock now starts when the target goes LOST, not when the lock
    fin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
    [behavior_node.py, perception_node.py, test_search.py]
2026-09-02 follow: half_fov_deg measured at 25.2, not the spec sheet 34.5
    The camera's 69 deg HFOV is correct and irrelevant. It describes the LENS,
    and the number this loop needs is the angle spanned by x = +/-1, where x is
    normalised across the DETECTOR's input. DetectionNetwork.build(camera, ...)
    requests that input with the default resize mode, which is CROP (enum 0), so
    the network sees a 416x416 CENTRE CROP of the sensor and x = 1 is a much
    narrower angle than the frame edge.
    Predicted 21.1 for a 16:9 source and 27.3 for 4:3 before measuring.
    Measured 25.2, between the two, which is where it should land.
    Method: with a stationary target x = (bearing - pan)/half_fov, so
    dx/dpan = -1/half_fov. Th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
    [follow.yaml, measure_fov.py]
2026-09-02 docs: a parts list you could actually order from, and the firmware build flags
    The hardware table said what things were, not which to buy: "Feetech STS3215
    + bus adapter" and "4S pack" are not orderable, and the whole pan axis was
    one row still marked "integration in progress".
    README now lists the vehicle, sensing and pan axis separately, marks what
    came with the course kit, and carries the detail that actually matters for
    each part rather than its name: set the VESC cutoff for 4S, put the mic in
    cardioid, the servo is serial-bus because the loop needs its MEASURED angle
    and the VESC's servo output is already taken.
    Says plainly what drives and powers the pan axis, which was nowhere befor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
2026-09-02 docs: correct an overstatement, no battery pack was lost
    I had written in three places that the wrong VESC cell count destroyed a
    pack. Magnus corrected that: no pack died. The cutoff was set for 3S on a 4S
    battery until 2026-08-29, which is worth recording because it puts the
    low-voltage cutoff at 2.25 V per cell, but the consequence I attached to it
    was mine and it was wrong.
2026-09-02 behavior: the keyword tier was silently dropping distances
    Found on the car: "forward 5 m", "reverse 10 cm" and "reverse 2 meters" all
    ran the DEFAULT three seconds. The calibration was fine; the distance never
    reached it.
    Two places dropped it. _parse_step returned only {'action': ...} and never
    looked for a quantity, and the single-command path then took step['action']
    and discarded the rest of the dict anyway. Distances had therefore only ever
    worked through the LLM tier, and "forward 5 m" matches the keyword `forward`
    so it never got there.
    Quantity parsing now lives in _parse_step, which is what chains and single
    commands share, and the result is carried through to _start.
    A UNIT IS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
    [behavior_node.py, test_keywords.py]
2026-09-02 follow: anchor the camera command to the measured angle, and tune it
    Reported: the camera overshoots. The cause was structural, not a gain. The
    inner loop did pan_cmd += correction, stacking increments onto the last
    command. The servo takes about half a second to settle while frames arrive
    every 80 ms, so six corrections piled up before the first had executed, each
    computed from an error the camera had not yet moved to correct.
    It now commands an ABSOLUTE angle anchored to the angle the camera HAD when
    the frame was taken. Successive frames during one move then ask for roughly
    the same place, and the command can never lie beyond the target's true
    bearing, so the axis converges onto it rathe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
    [follow.yaml, follow_node.py, rosstub.py, sim_cascade.py]
2026-09-02 docs: how the app is built and how it talks to the robot, plus an identity pass
    New docs/app-and-comms.md, which was the largest gap for anyone reading this
    cold: the control surface was described everywhere by what it does and
    nowhere by how it works.
    Covers the page being a single file with NO build step and why that is
    deliberate for something that is a moving vehicle's emergency stop; that
    voice_bridge_node is one process running FastAPI and rclpy together, so a
    phone message becomes a ROS message in-process with no broker; the full
    message protocol in both directions with the topic each maps to; why HTTPS
    is required rather than nice (browser speech and microphone APIs do not
    exist out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
    [behavior.yaml, follow.yaml, llm_node.py]
2026-09-02 docs: make the repo actually reproducible, not just readable
    The dependencies were never declared. setup.py said install_requires
    ['setuptools'] while the code imports fastapi, uvicorn, depthai, cv2, numpy,
    vosk, pyserial and pyvesc, so a clone would have failed with one ImportError
    at a time and no indication of what to install.
    requirements.txt now groups them by what you want to run, setup.py declares
    the light ones with the heavy ones as extras, and package.xml lists the pip
    packages it depends on at runtime.
    Splitting them that way matters because of what the audit turned up: the
    phone app needs ONLY fastapi and uvicorn. It does not need the camera, the
    speech model or the servo. So t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
2026-09-02 README: restructure to the class convention, and correct stale claims
    Read two other 148 final-project repos in the class org (teams 5 and 9) and
    followed the skeleton they share: title with course and team, table of
    contents, team members with department, promises against what was
    delivered, challenges, if-we-had-another-week, documentation split into
    software/hardware/CAD, usage, acknowledgements, contact. That skeleton also
    matches the presentation template, which is a good sign it is what is wanted.
    More importantly the README had drifted and was UNDERSELLING the project:
    - said the LLM tier was "designed but not built". It has been working for
    days, so the natural-language nice-to-h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
2026-09-02 audit: fix a duplicate-key config, a stale default, and a misleading preset
    Full pass over the repo before it goes to the class org. Five real defects,
    none of which were visible from the outside.
    1. config/behavior.yaml had DUPLICATE KEYS. The original guesses for
    metres_per_second, degrees_per_second and turn_around_seconds were still
    in the file above the measured values appended later. YAML takes the
    last, so the car was running the correct numbers, but a reader would have
    seen 0.9 m/s at the top and believed it, and reordering the file would
    have silently changed the vehicle's behaviour.
    2. follow_node's half_fov_deg default was still the spec-sheet 34.5, with a
    comm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
    [behavior.yaml, follow_firstrun.yaml, follow_node.py, measure_fov.py, test_safety_guard.py]
2026-09-03 README: demo video, as a hero thumbnail and its own section
    GitHub sanitises iframes, so a YouTube player cannot be embedded in a
    README. The convention, and what the other 148 teams did, is a thumbnail
    image linking to the video, which is what this uses.
    Placed twice on purpose: a large one directly under the title, where a
    grader opening the repo sees it before anything else, and a smaller one in a
    Demo section that the table of contents points at, for anyone reading top to
    bottom.
    Verified the thumbnail actually resolves before committing it. maxresdefault
    returns 200 with a real 92 KB frame rather than YouTube's grey placeholder,
    which is what you get for videos that never generated on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
2026-09-03 Add CAD files, logos, contacts, and the TA names
    CAD: 12 files, 3.0 MB, in cad/. Five parts have STEP and STL, two are STL
    only. Both formats matter for different reasons and the README says which:
    STL prints as-is, STEP is the one someone can open and modify for a
    different servo or camera, which is the whole point of a repo meant to be
    reproducible.
    Dimensions in the CAD table are bounding boxes measured from the meshes
    themselves rather than quoted, so they are the printer's envelope.
    Two things flagged in the file for confirmation before submission rather
    than guessed at: Stepper_Motor_Mount is named for a stepper this vehicle
    does not have, and it is not stated which parts the team mo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
    [Camera_Angle_Bracket.step, Camera_Angle_Bracket.stl, Camera_Angle_Mount.step, Camera_Angle_Mount.stl, Camera_Chassis_Mount.step, Camera_Chassis_Mount.stl, Front_Support.stl, Hinge_Body.STL]
2026-09-03 Team details, and rename the stepper mount to Servo_Mount
    Class years and Naveen's email in. Stepper_Motor_Mount replaced by
    Servo_Mount, which is the same part renamed: identical 87 x 3 x 80 bounding
    box, verified from the mesh rather than assumed.
    Still open: a team photo, a photo of the car, the presentation PDF, and
    saying which CAD parts were modelled by the team versus taken from the kit.
    [Servo_Mount.step, Servo_Mount.stl]
2026-09-03 Add the vehicle photo and interface captures, and reframe the app
    The app was described as a convenience: "a phone is the only controller
    that is always to hand". That undersells what it is. It is the operator's
    console for a moving vehicle, and the only way a human takes the car back
    once autonomy has it: the arm gate, the kill switch, the manual override
    that outranks autonomy, and the guard override all live there. Being a web
    page is a consequence of that requirement, not the reason for it.
    Both the README and docs/app-and-comms.md now lead with that, including the
    tab-as-mode behaviour, which is a control decision rather than navigation:
    opening Drive suppresses autonomy so the car can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
2026-09-03 CAD: state that every part was modelled by the team
    Closes the last two open items in the README. No renders: the printed
    assembly is clearly visible in the vehicle and team photographs, so a render
    would repeat what a reader can already see.
    Left a note that Front_Support and Hinge_Body are STL only. Since they were
    modelled here the solid geometry exists, so exporting STEP would complete
    the set, but it is not required.
2026-09-03 CAD set and team details
    Keep only the five parts we modelled, each with STEP and STL. Departments
    written out in full with their abbreviations.
    [Front_Support.stl, Hinge_Body.STL]
2026-09-03 app: the voice tab listed only the original seven commands
    It had not been updated as the vocabulary grew, so it omitted turn around,
    the three point turn, the figure eight and every camera command, and said
    nothing about distances, angles or chaining. Someone reading the tab would
    conclude the car does far less than it does.
2026-09-03 CAD: sync the full set, eight parts
    Adds the baseplate, and the STEP files for the front support and the hinge,
    which previously existed only as meshes. Every part now ships as both STEP
    and STL, so the whole assembly can be modified rather than only reprinted.
    Bounding boxes measured from the meshes, so they are the printer's envelope
    rather than nominal figures.
    [Baseplate.STEP, Baseplate.STL, Front_Support.STEP, Front_Support.STL, Hinge.STEP, Hinge.STL]
2026-09-04 Demo section: describe both videos and fix the layout
    Markdown table cells gave the two thumbnails wildly different sizes because
    image width is not controllable that way. Switched to an HTML table with
    50% columns and full-width images, so both sit equal.
    Demo two now says what it shows: the drive primitives end to end, and manual
    remote driving from the phone with the live video feed.
2026-09-04 Header: drop the single demo thumbnail
    It sat directly above the Demo section, so the first video image on the page
    was Demo one alone rather than the two side by side. The Demo section below
    already shows both frames with their descriptions, which is the layout worth
    leading with. The header keeps the links.
